ban9975/Thesis/README.md

# Hand Gesture Recognition Wristband Based on Resistance Sensing
## Abstract
Hand gesture recognition is a popular research topic, especially in the field of Human-Computer Interaction (HCI). This study focuses on developing a wearable hand gesture recognition device for human-computer interaction, which can be used to give commands to smart assistants through gestures or be utilized as an input interface for VR/AR systems with entertainment purposes.  

We aim to achieve several characteristics: comfort while wearing, usability anytime and anywhere, privacy preservation, and low cost. However, existing projects do not fully meet our requirements. Technologies based on computer vision and wireless signal detection lack mobility, while current wearable gesture recognition wristbands are not wearable enough. The closest existing work to our requirements is a wristband based on capacitive sensing, capable of detecting changes in wrist contours to recognize gestures. Nonetheless, this work has a drawback as the wristband is made from rigid silicone, leading to discomfort during wear, and it has a complex structure, resulting in higher production costs.  
 
Therefore, this study aims to improve this wristband design by retaining the idea of wrist contour recognition but using different types of sensors for recognition. After trying various materials, we discovered a material called conductive rubber. Conductive rubber is soft, elastic, and comfortable to wear, making it seemingly suitable for HCI devices. However, few works have utilized this material due to the nonlinearity between resistance change and elongation proportion.  

In this study, we first conducted extensive measurements on conductive rubber cord to build a model for the resistance change of it. We found that resistance value exhibits significant changes when subjected to small extensions. Based on this discovery, we decided to use conductive rubber cord as a sensor on the wristband and employ a resistance sensing approach for gesture recognition. We then created the wristband using conductive rubber cords and denim fabric. By employing the previously developed resistance model and a calibration algorithm for the collected data, we fed the calibrated data into a Random Forest Classifier to recognize the gestures made by the user.
## Experiment Instruction
### Video Link
https://youtu.be/pAtT-bNWfoI
### System Overview   
#### Hardware Setup
We used Arduino Uno to collect signals from conductive rubber cords. The analog signals would be converted to digital signals by ADC module ADS1015 first, and then transferred to PC via bluetooth module HC-05.  
system_s
#### Bluetooth Connection  
* Bluetooth program cou be found in **4 Program/BT_pyServer/**.  
* Find out which COM port does your PC use to connect to the bluetooth module.  
  Find the COM port (Windows) by selecting **Start > Settings > Devices > Bluetooth & other devices** and then **More Bluetooth options > COM ports**. Our bluetooth module is called `BioLabG2` here.  
  btCOM
* Change the COM port in **4 Program/BT_pyServer/interface.py**, line 10, 11.
  ```python
  while(not self.ser.do_connect("<YOUR_COM_PORT>")):
    self.ser.do_connect("<YOUR_COM_PORT>")
  ```
### Stretch-Resistance model of Materials
#### Collecting Data
We saved the measured data in **3 Data/materials/**. While running, this program printed the resistance values on console. We then copied these values into excel files manually.  
* Connect the testing sample between A0 on ADC and ground.  
  circuit_sample
* Upload **4 Program/BT_Arduino/BT_resistance/BT_resistance.ino** to Arduino board.
* On PC, run the measuring program. This program measures one value at a time.  
  ```bash
  > cd "4 Program/BT_pyServer/"
  > python BTRes_print.py
  ```
* In each run, this program asks how many iterations you'd like to test. The default value is 1 iteration.  
* Enter `e` to close the program.  
#### Fit the Surface for **calibration with length**
* Open **4 Program/plot/draw3D.m**.
* Specify the file containing measurement data in line 13.
  ```Matlab
  resT = readtable("<PATH_TO_FILE>", opts, "UseExcel", false);
  ```
* After running the code, the parameters of fit surface are shown on the console. These values are used in `calibration with length` in the training phase.
 * Key the values into **4 Program/rf/importDataRaw.py**, line 6\~14 and 29\~37. The values here are generated from `fitType="poly23"`.
   ```python
   p00 = -0.619036213083872
   p10 = -0.030800170966657
   p01 = 1.688322998396718
   p20 = -0.000611641511412
   p11 = 0.057794560352152
   p02 = -1.531793071531490
   p21 = 0.000488277935669
   p12 = -0.025444713548645
   p03 = 0.462421072634841
   ```
### Resistance Values of Gestures
#### Gestures Set
gestures  
#### Collecting Data
We saved the measured data in **3 Data/wristbands/**. While running, this program saved the measured values to the specified file automatically.
* Upload **4 Program/BT_Arduino/BT_resistance/BT_4resistance.ino** to Arduino board.
* Specify which file you want to write in `fileName` in **4 Program/BT_pyServer/BTRes_saveRaw.py**, line 10. Note that this file should be an existing file.  
* On PC, run the measuring program. This program measures four values at a time.  
  ```bash
  > cd "4 Program/BT_pyServer/"
  > python BTRes_saveRaw.py
  ```
  This program will ask you which measuring mode do you want to use once you run it. There are two modes: `calibration` and `random`.
 *  Measure in `calibration` mode.  
    We use `stretch` gesture as the calibration gesture. In calibrication mode, this program asks you to perform `stretch` several times. In our experiment, we collect 15 measurements for calibration data.  
 *  Measure in `random` mode.  
    In random mode, this program asks you to perform each gesture respectively. In our experiment, we collect 105 measurements for training dataset and 35 measurements for testing dataset.  
 * Enter `e` to close the program.
### Recognizing Gestures Using Random Forest
```bash
> cd "4 Program/rf/"
> python rfRaw.py
```
This program will ask you to choose the calibration mode and the version of the wristband. And then, you can decide whether to save the calibrated data. The calibrated data is saved in **5 Result/wristband/calibrated/** if you choose to save it. The `calibration with length` mode takes more time than other calibration modes.  

After finish the prediction, this program will show the training/validation/testing accuracy, respectively, on the console, and then generate the confusion matrices for validation and testing results. The confusion matrices are saved in **5 Result/wristband/conMat/**.
### RandomizedSearchCV
This program was designed to find the optimal hyperparameter set.  
You can specified the range of each parameter you want to test in **4 Program/rf/rf_randomizeCVRaw.py**, line 17\~23. The parameters are: `n_estimators`,  `max_features`, `max_depth`, `min_samples_split`, `min_samples_leaf`, and `bootstrap`.
```bash
> cd "4 Program/rf/"
> python rf_randomizeCVRaw.py
```
After randomly try on the parameter set for `n_iter` rounds, this program shows the set with highest accuracy on the console.
### Generating the Plots
#### plot_material.py
This program generates plot for single length. I draws each set of measurement as a line and computes the standard deviation and average of these values. You need to type file name and sheet name as command line arguments.
```bash
> cd "4 Program/plot/
> python plot_material.py <FILE_NAME> <SHEET_NAME>
```
There are some inputs needed:  
`_length`: a float, 
`_start`: an int, specify the starting row of the data.  
`_end`: an int, specify the ending row of the data.  
`_reps`: an int, specify how many repetitions in each set.
`_sets`: an int, specifies how many sets of values do we measure.  
`plotName`: a string. The plot will be saved as **5 Result/rubberCord/\<PLOTNAME\>.png**  

In the previous experiments (**otherMaterials.xlsx**), we took 5 samples (_reps = 5) at a time and repeated it for 3 sets (_sets = 3). After moving on to measure the resistance values of conductive rubber cords, we changed the experiment setup and took only 1 samples at a time and repeated it for 10 sets.

Following are sample input and the resulted plots:  
  
8cm
8cm_SD  
This program can generate plots using `stretch`, `reps', and 'angle' as x-axis. There are some lines need to be commented/uncommented. Please find details in the code.

#### plot_all.py
This program generates "Overall" plots. It takes average of different values measured from the same length and stretch. You need to type file name and sheet name as command line arguments.
```bash
> cd "4 Program/plot/
> python plot_all.py <FILE_NAME> <SHEET_NAME>
```
There are some inputs needed:  
`_start`: a list of ints, specify the starting row of each line.  
`_end`: a list of ints, specify the ending row of each line.  
`_sets`: an int, specifies how many measurements for each (length, stretch) pair. This also means how many columns of data do we have. 
`_lines`: an int, specifies how many lines will be drawn on the plot.  
`plotName`: a string. The plot will be saved as **5 Result/rubberCord/\<PLOTNAME\>.png**  

Following are sample input and the resulted plot:  
  
newCord_20_all  
This program can generate plots using `stretch`, `length + stretch', and 'angle' as x-axis. There are some lines need to be commented/uncommented. Please find details in the code.
#### plot_wristband.py
This program generates a scatter plot with different gestures for each sensor. The plots will be saved in **5 Result/wristband/calibrated/plot/**.  
```bash
> cd "4 Program/plot/
> python plot_wristband.py
```
Following are sample input and the resulted plot:  
  
v4_gesture_0
v4_gesture_1  
v4_gesture_2
v4_gesture_3
