ban9975/Thesis/1 Presntation/20230612 oral defense.pdf

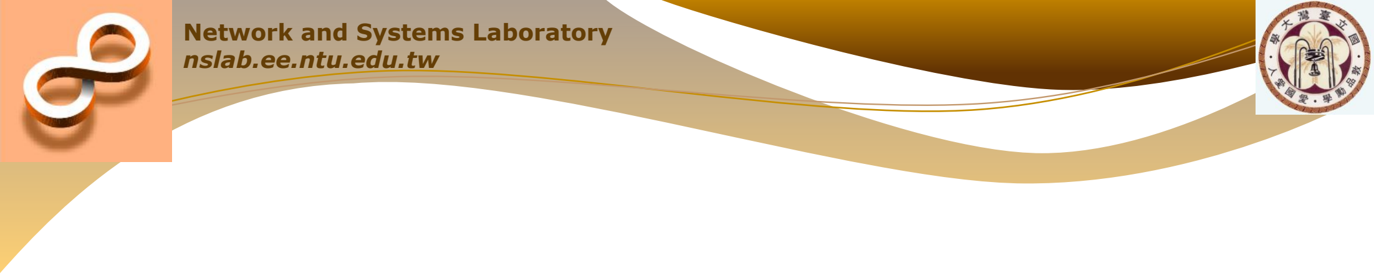
[picture p75: figure]
Network and Systems Laboratory nslab.ee.ntu.edu.tw

## Hand Gesture Recognition Wristband Based on Resistance Sensing

R10921072 Pei-Shin Hwang 黃珮欣 Network and Systems Laboratory Graduate Institute of Electrical Engineering National Taiwan University
June 12th, 2023
Copyright © 2008 | 1

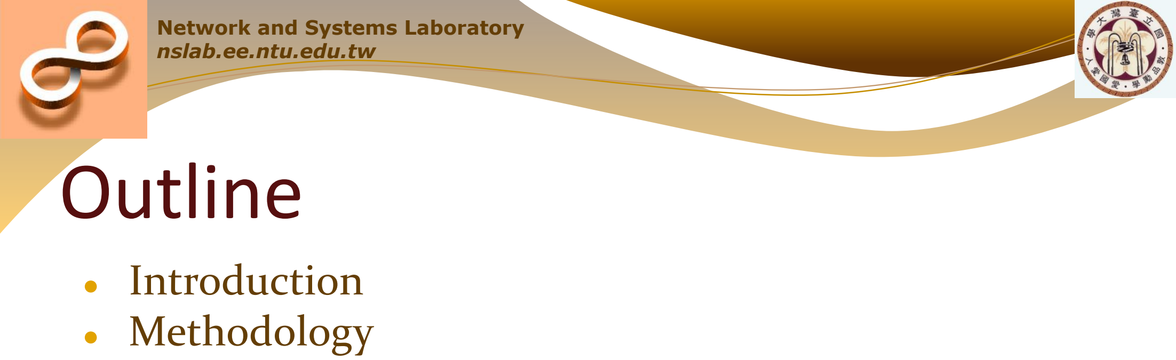
[picture p76: figure]
Outline; ● Introduction ● Methodology

- Exploration of Materials
- Experiments
- Results
- Conclusion
- Q&A

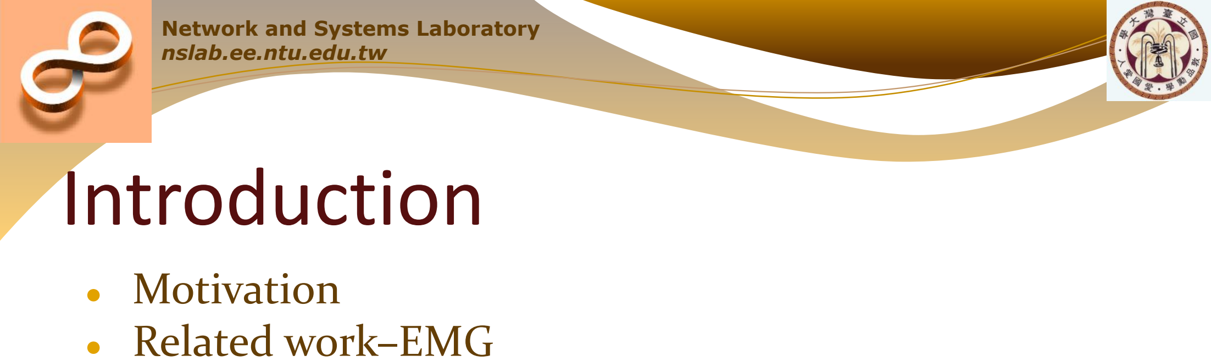
[picture p77: figure]
Introduction; ● Motivation ● Related work–EMG

- Related work–flex sensor
- Related work–CapBand
- Thesis statement
- Contributions

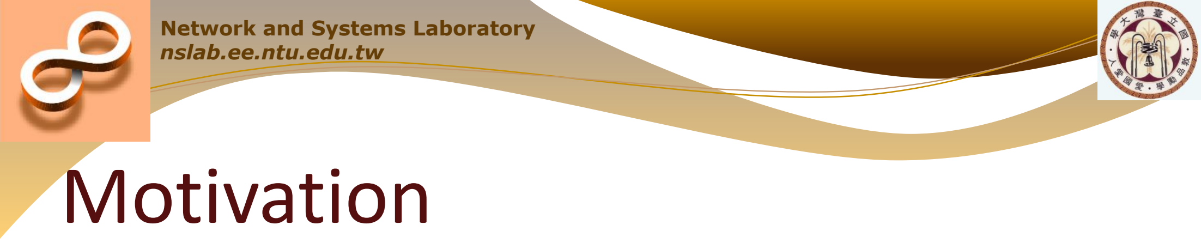
[picture p78: figure]
Motivation

Why are current hand gesture recognition systems not suitable for everyday use:
- Vision based:
- Privacy
- High compute capacity needed
- Wireless signal based:
- Low gesture resolution
- Room-scale recognition
- Wearable devices:
- Not wearable enough

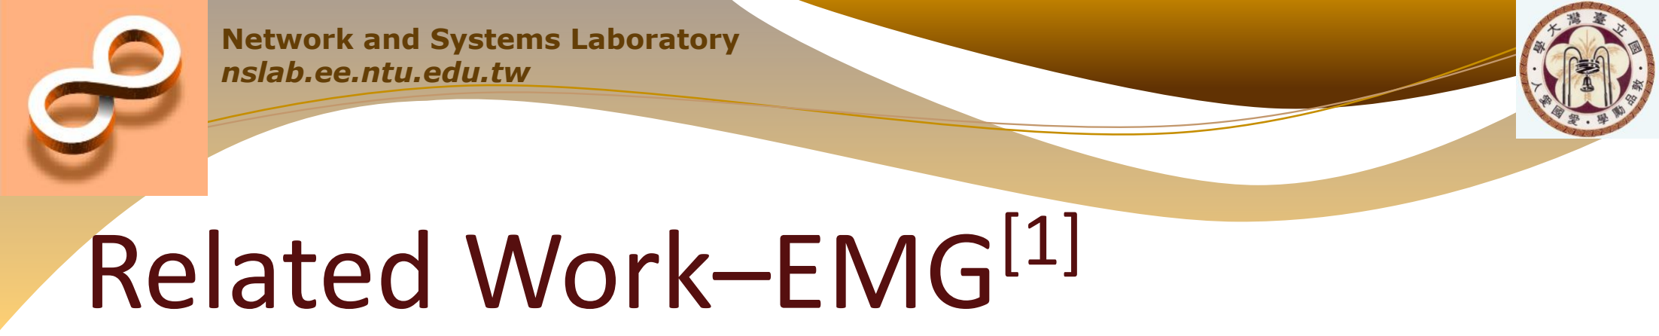
[picture p79: figure]
Related Work–EMG[1]

- Sense the neural signal produced by our brain
- Need to attach electrodes on users’ skin surface

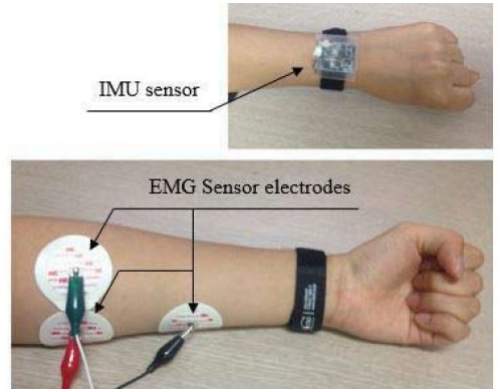
[picture p80: figure]

# Related Work–Flex Sensor[2]

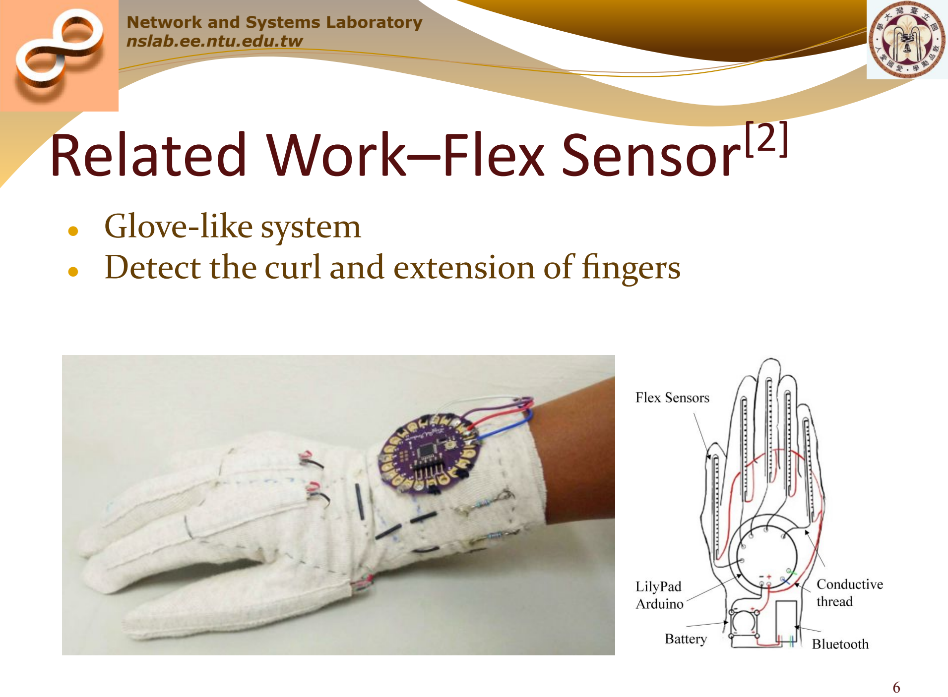
[picture p81: page 6]

- Glove-like system
- Detect the curl and extension of fingers

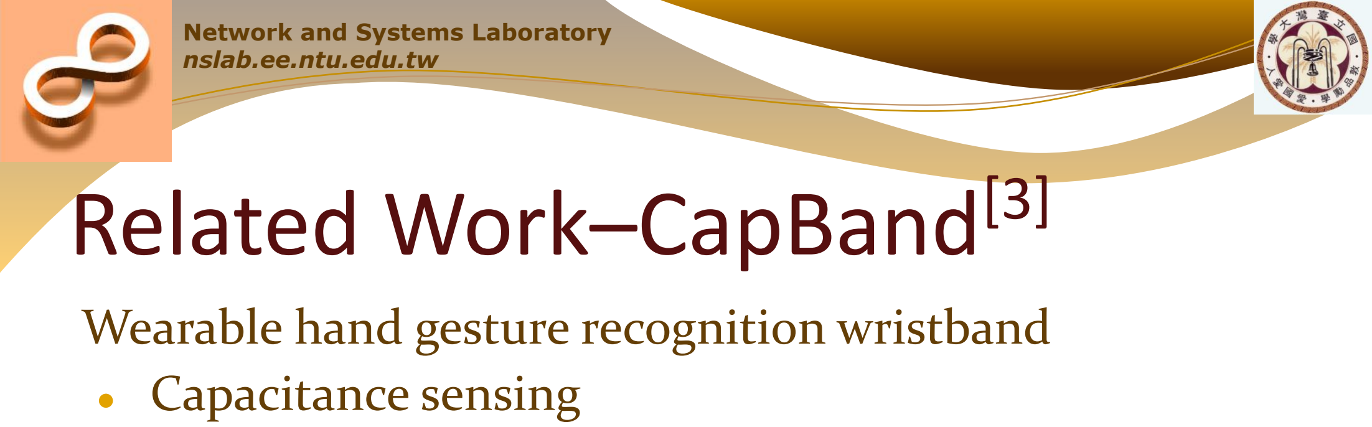
[picture p82: figure]
Related Work–CapBand[3]; Wearable hand gesture recognition wristband ● Capacitance sensing

- Recognize gestures by wrist contour
- Down side:
- Costly
- Tight
- Hard

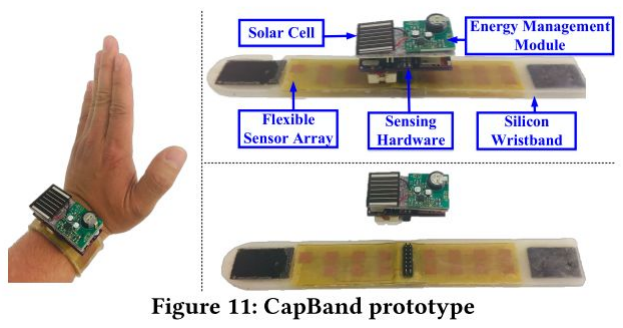
[picture p83: figure]

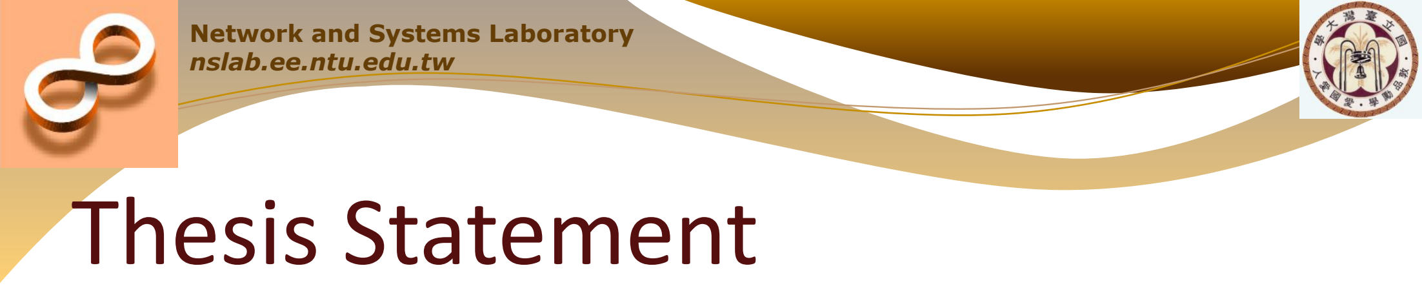
[picture p84: figure]
Thesis Statement

Goal: a CapBand-like wristband but with lower cost and more comfortable
How:
- Recognize gestures by wrist contour
- Use soft material to make the wristband
- Make wristband with cheaper and simpler structure
- Denim fabric
- Conductive rubber cord

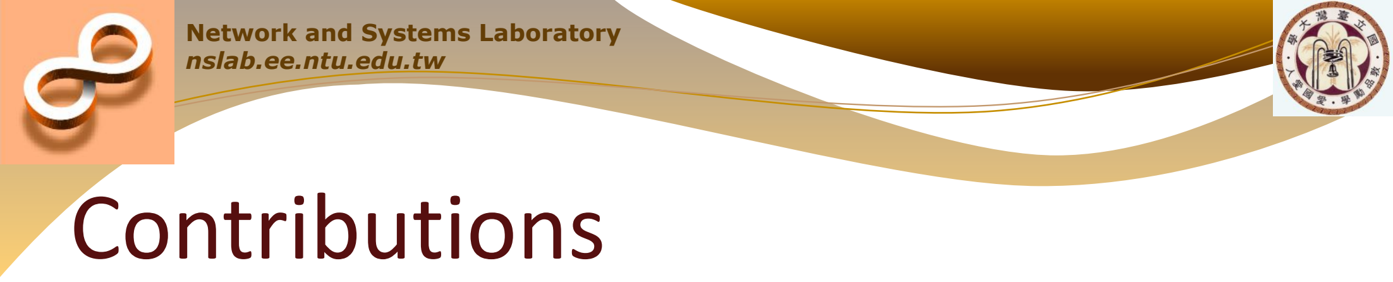
[picture p85: figure]
Contributions

- Find a material suitable for sense the length change
- Build a model between the resistance value and length of conductive rubber cord
- Make a wristband using conductive rubber cord

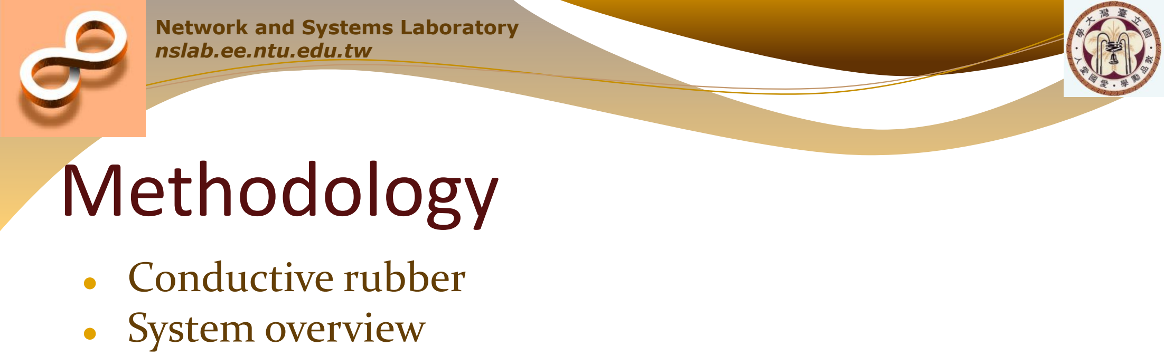
[picture p86: figure]
Methodology; ● Conductive rubber ● System overview

- Measurement of conductive rubber cord
- Wristband design
- Recognition flow

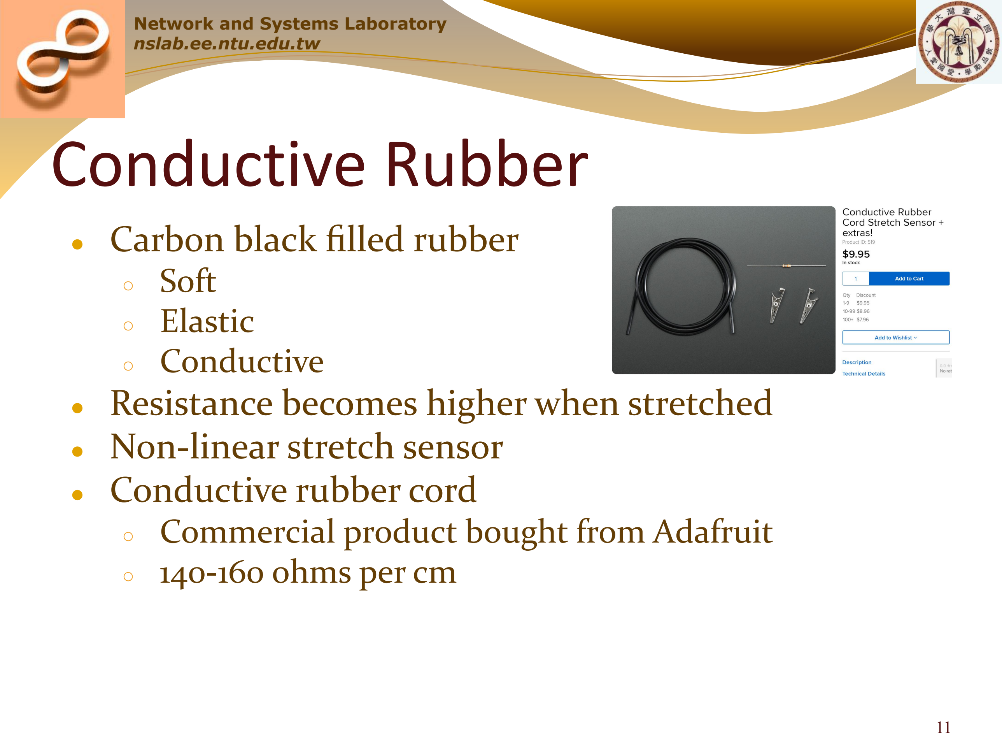
[picture p87: figure]
Conductive Rubber; ● Carbon black filled rubber ○ Soft ○ Elastic ○ Conductive; ● Non-linear stretch sensor ● Conductive rubber cord; ○ 140-160 ohms per cm

- Resistance becomes higher when stretched
- Commercial product bought from Adafruit

# System Overview–Hardware

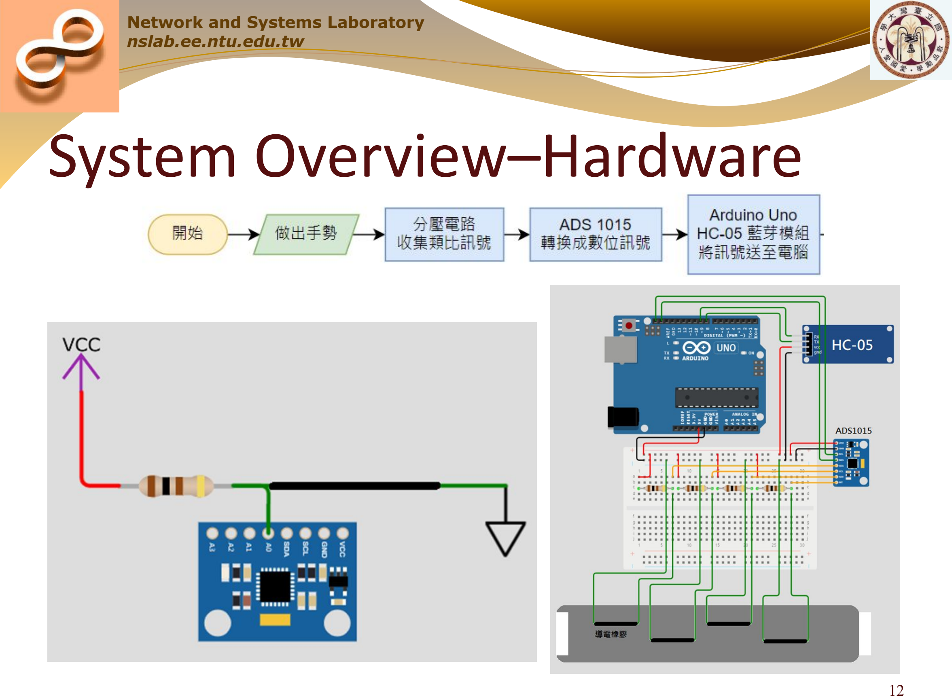
[picture p88: page 12]

## Measurement of Conductive Rubber Cord

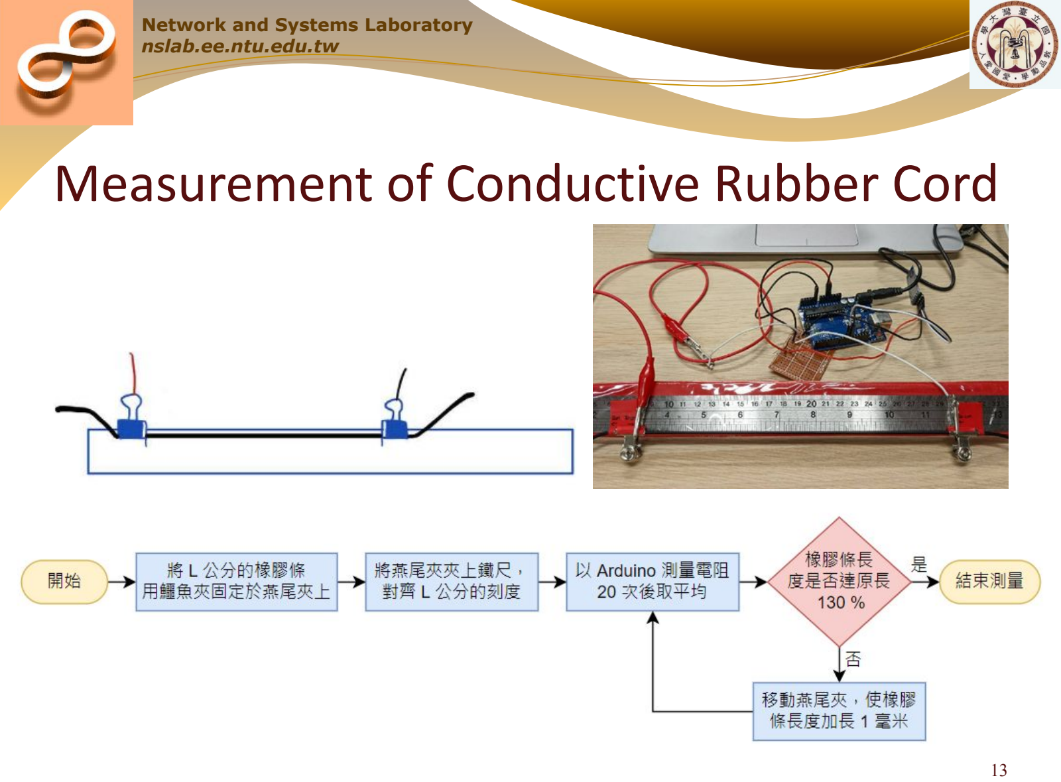
[picture p89: page 13]

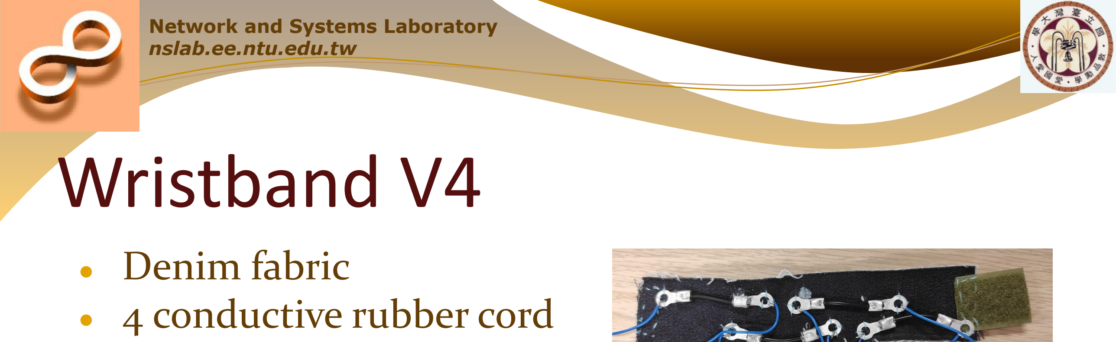
[picture p90: figure]
Wristband V4; ● Denim fabric ● 4 conductive rubber cord

- 2 cm each

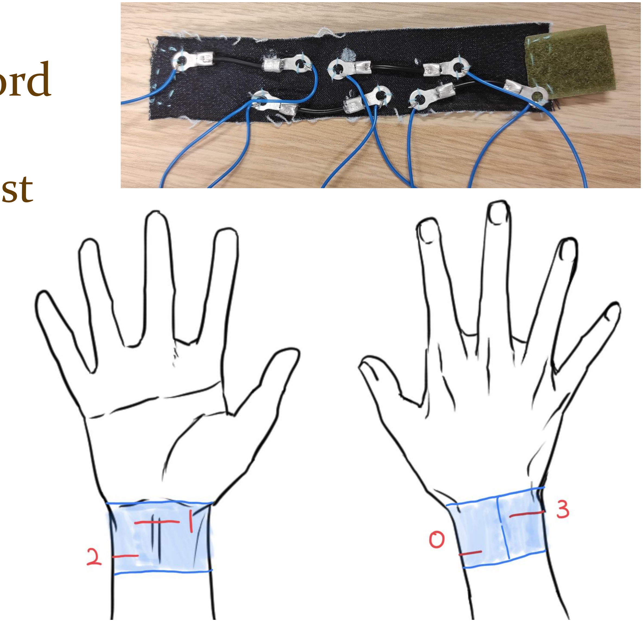
[picture p91: figure]

- Wrap around the wrist

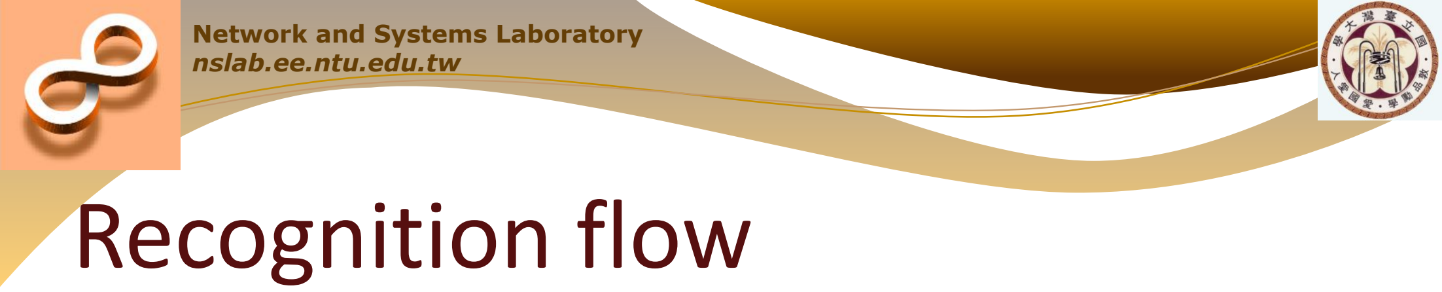
[picture p92: figure]
Recognition flow
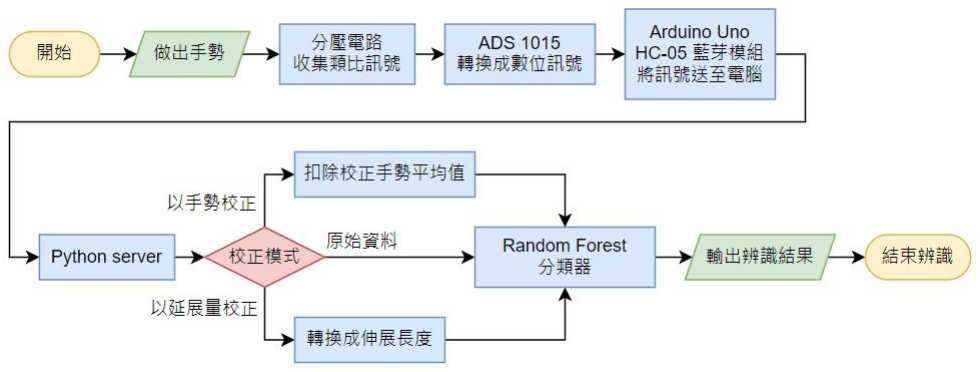
[picture p93: figure]

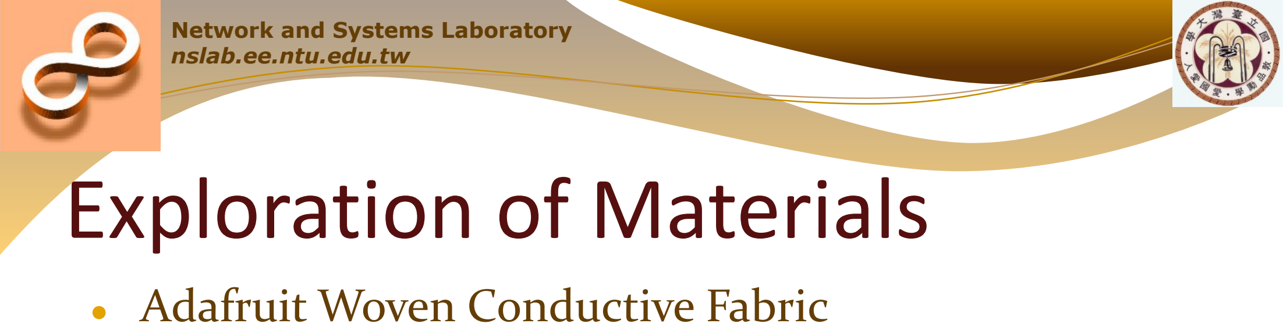
[picture p94: figure]
Exploration of Materials; ● Adafruit Woven Conductive Fabric

- Adafruit Knit Jersey Conductive Fabric
- Adafruit Conductive Rubber Sheet
- Adafruit Conductive Rubber Cord
- Length-Resistance Model of Rubber Cord

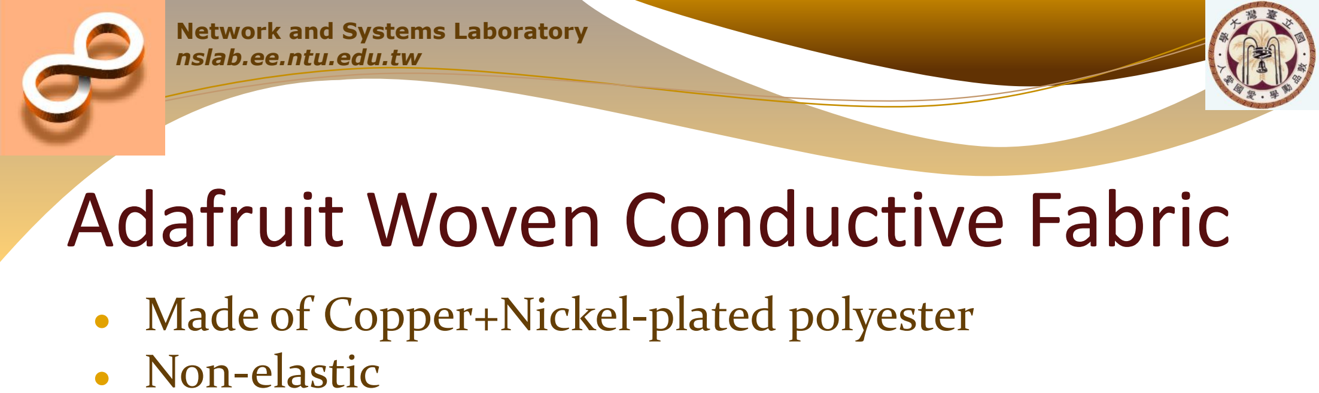
[picture p95: figure]
Adafruit Woven Conductive Fabric; ● Made of Copper+Nickel-plated polyester ● Non-elastic
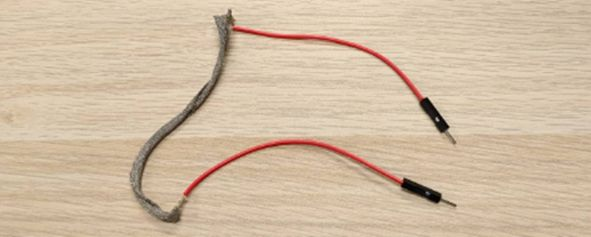
[picture p96: figure]

## Adafruit Knit Jersey Conductive Fabric

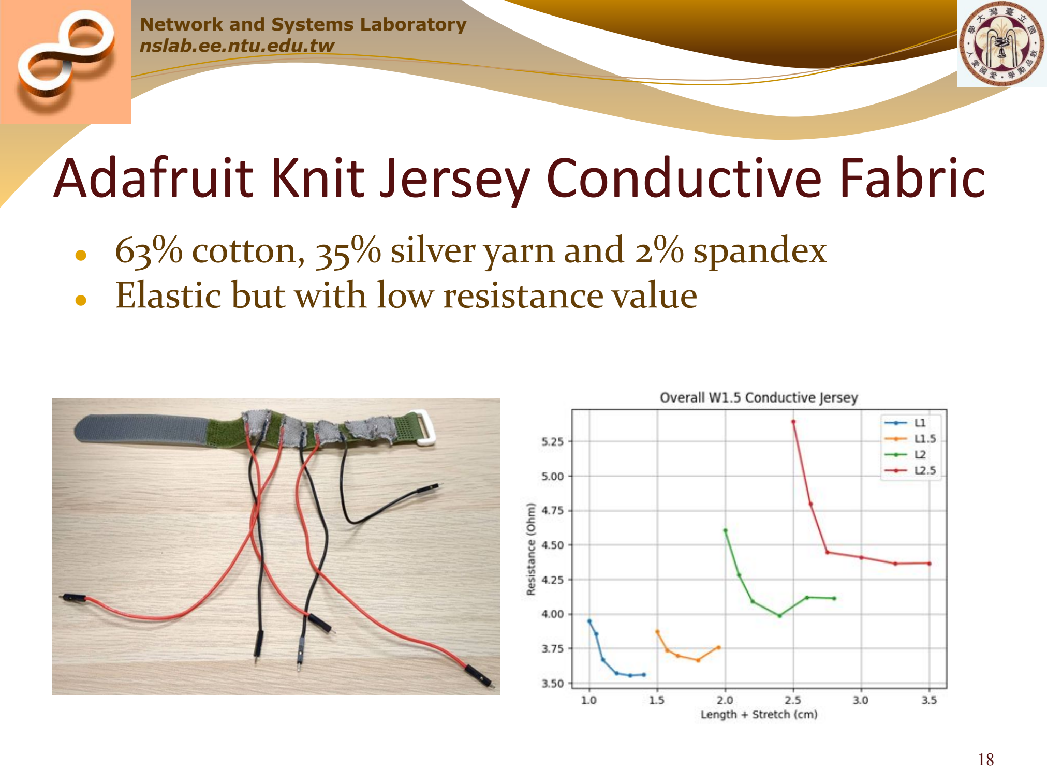
[picture p97: page 18]

- 63% cotton, 35% silver yarn and 2% spandex
- Elastic but with low resistance value

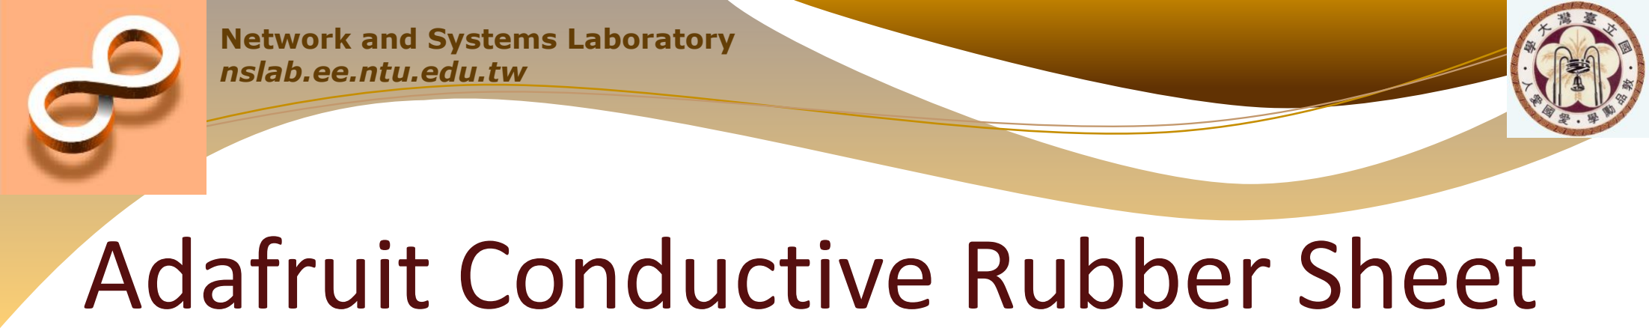
[picture p98: figure]
Adafruit Conductive Rubber Sheet
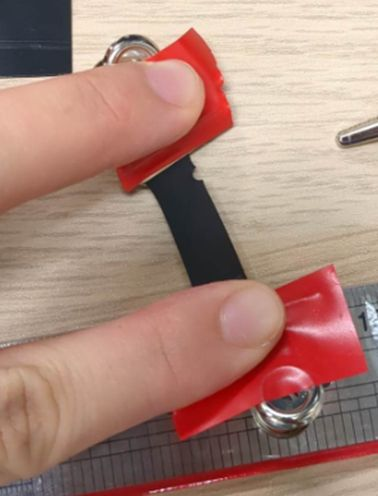
[picture p99: figure]
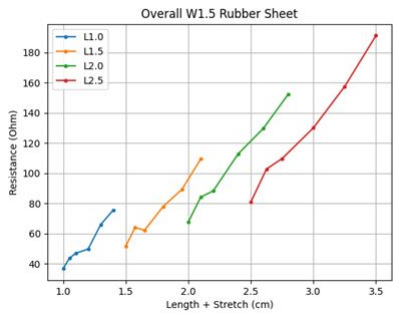
[picture p100: figure]

- Made of carbon-black impregnated rubber material
- Take long time to recover after stretched
- Not durable enough

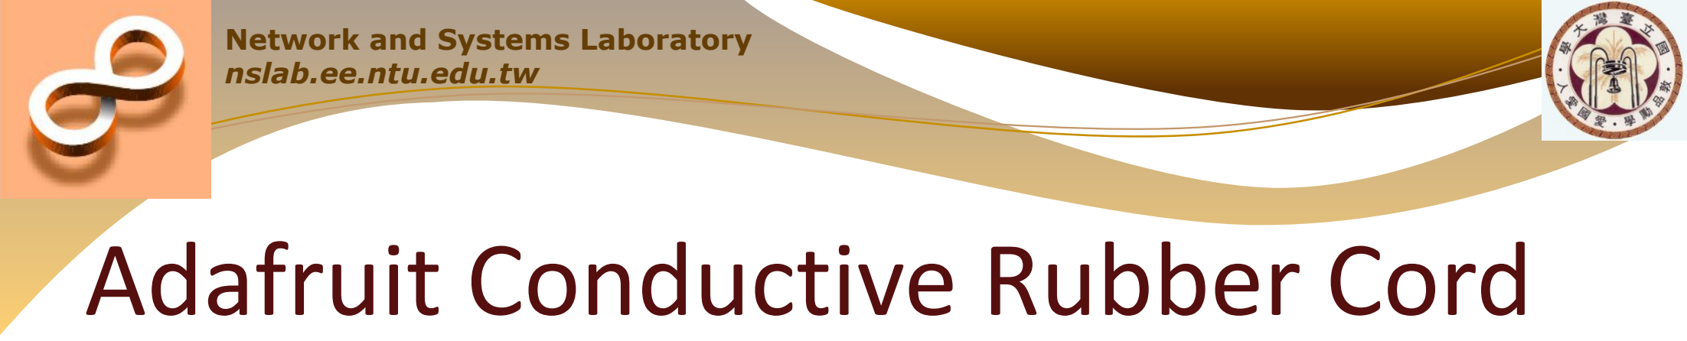
[picture p101: figure]
Adafruit Conductive Rubber Cord

- Made of carbon-black impregnated rubber material
- Resistances rise fast when slightly stretched

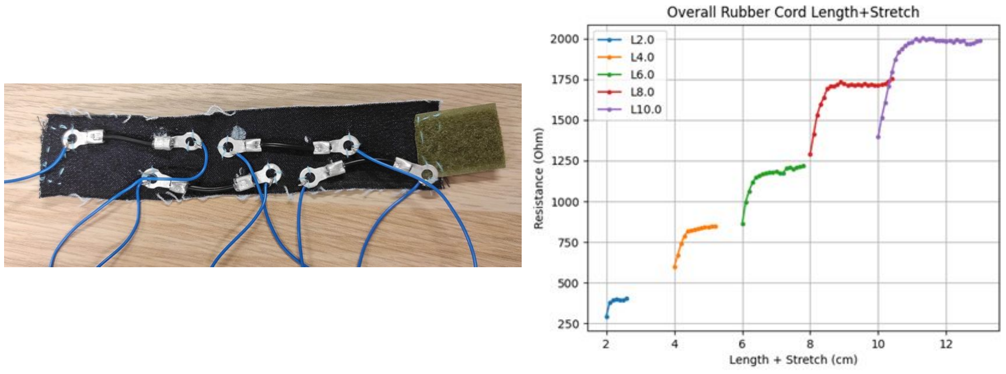
[picture p102: figure]

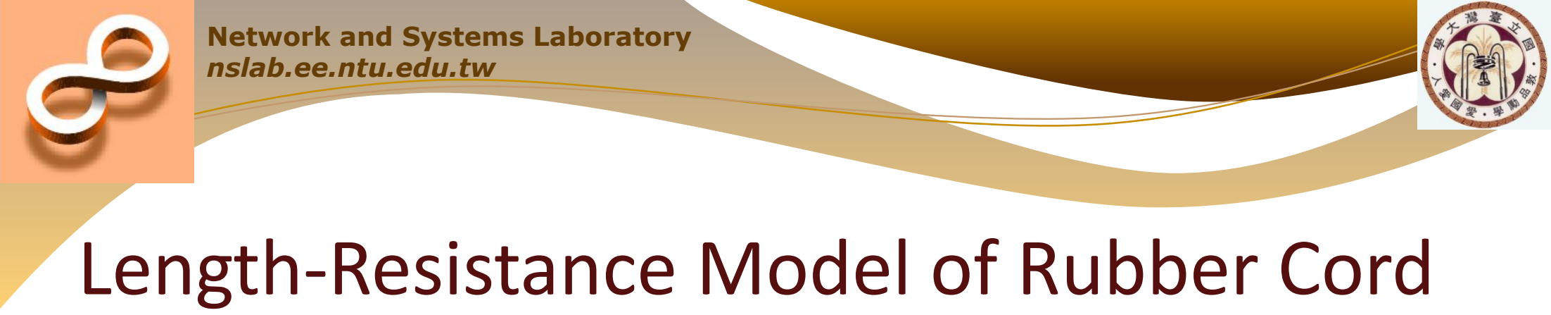
[picture p103: figure]
Length-Resistance Model of Rubber Cord

- Matlab fit with fit type poly23
- Data size: (5 + (2 + 4 + 6 + 8 + 10) * 2) * 10 = 650

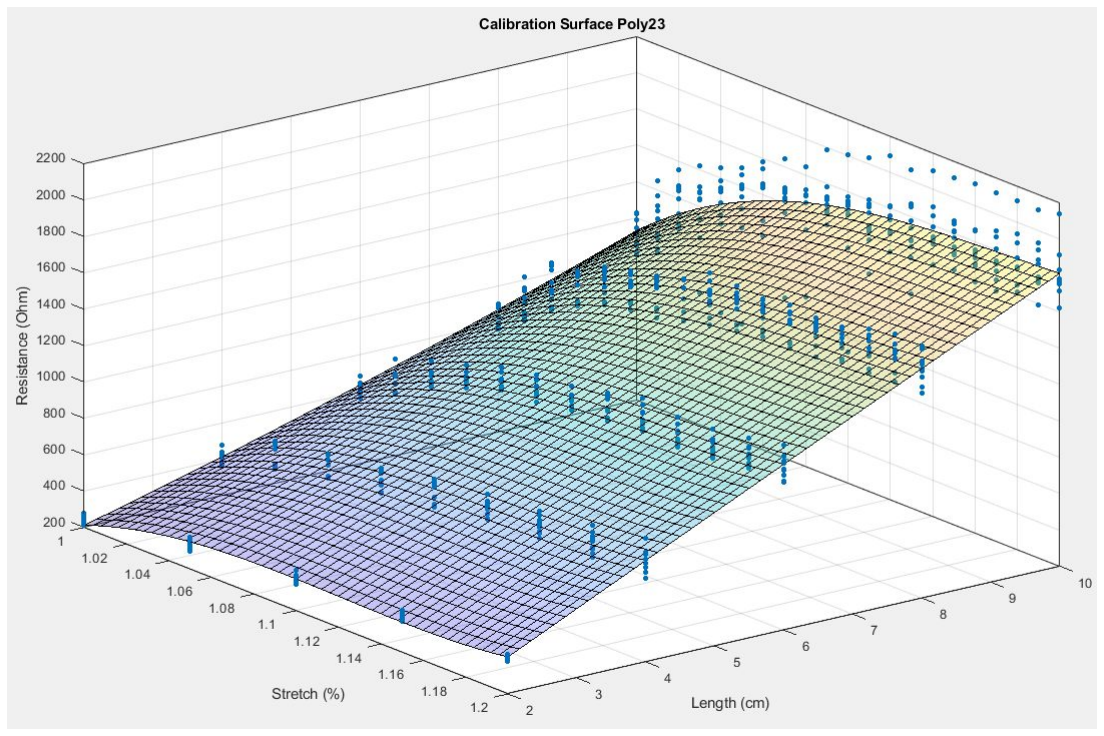
[picture p104: figure]

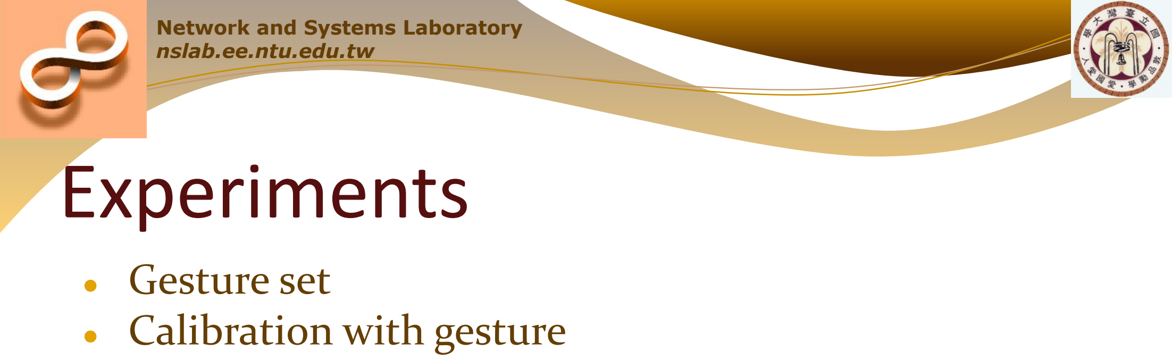
[picture p105: figure]
Experiments; ● Gesture set ● Calibration with gesture

- Calibration with length
- Length-Resistance Model for Calibration
- Random forest classification

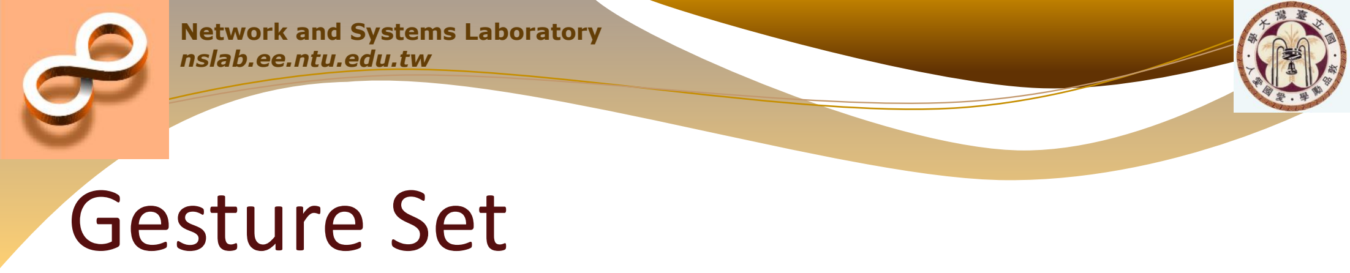
[picture p106: figure]
Gesture Set

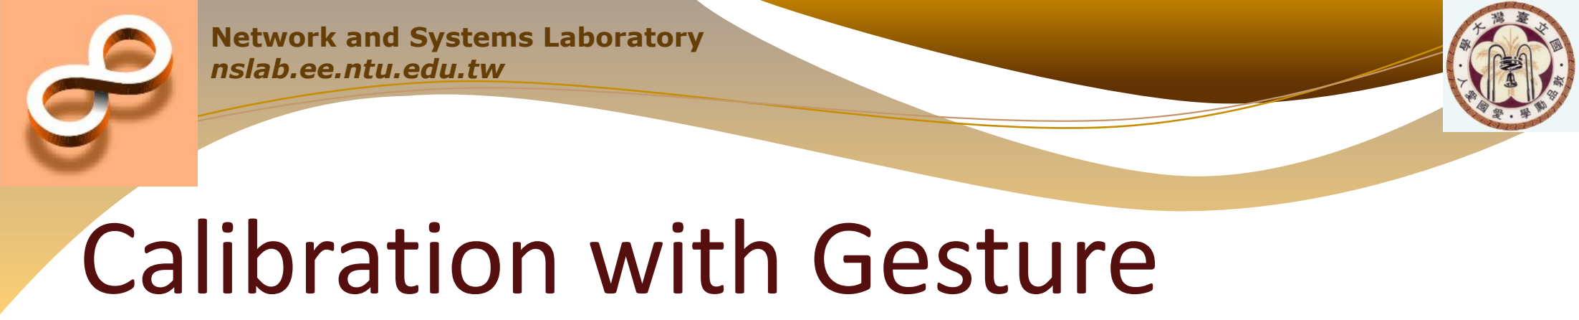
[picture p107: figure]
Calibration with Gesture
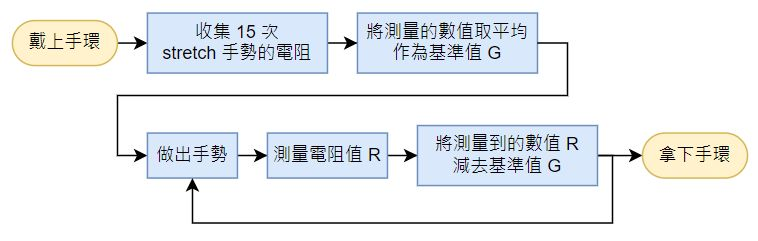
[picture p108: figure]

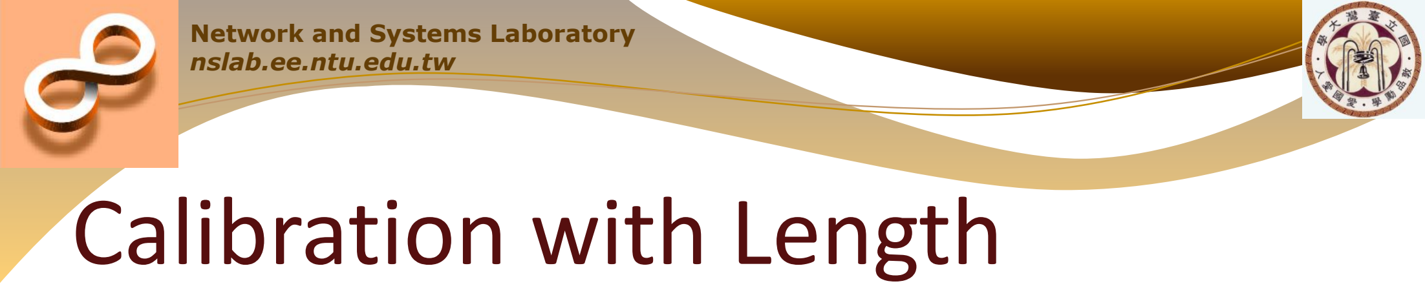
[picture p109: figure]
Calibration with Length
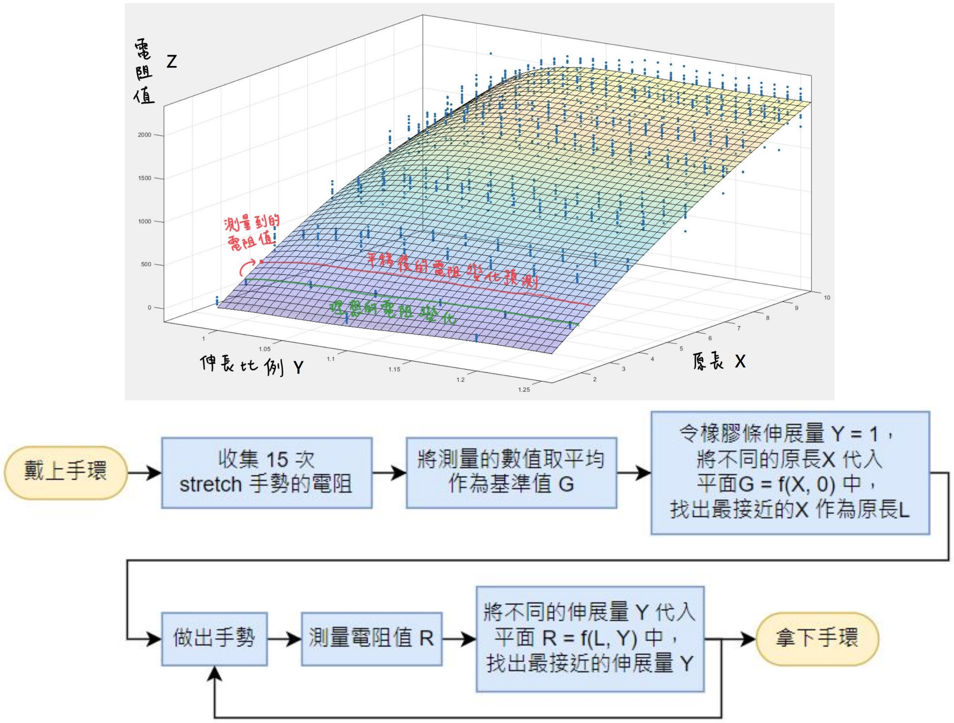
[picture p110: figure]

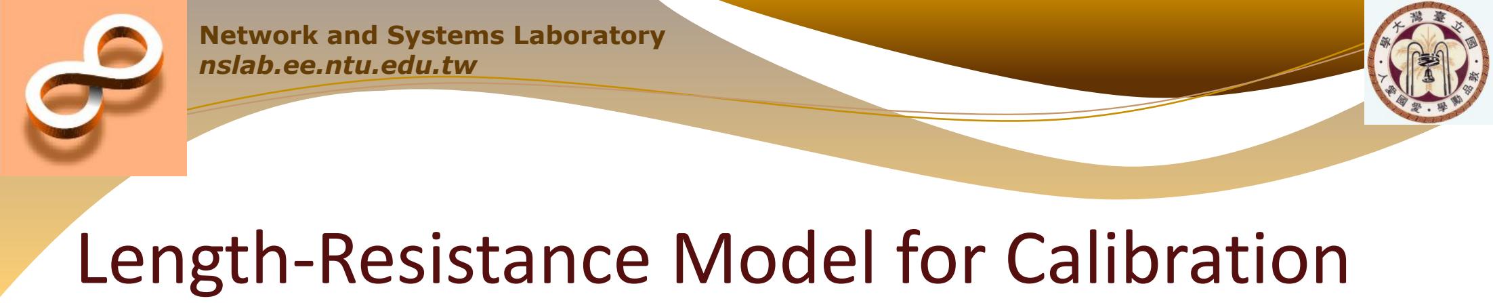
[picture p111: figure]
Length-Resistance Model for Calibration

- Matlab fit with fit type poly23
- Data size: (4 + (1 + 2 + 3 + 4) * 2) * 10 = 240

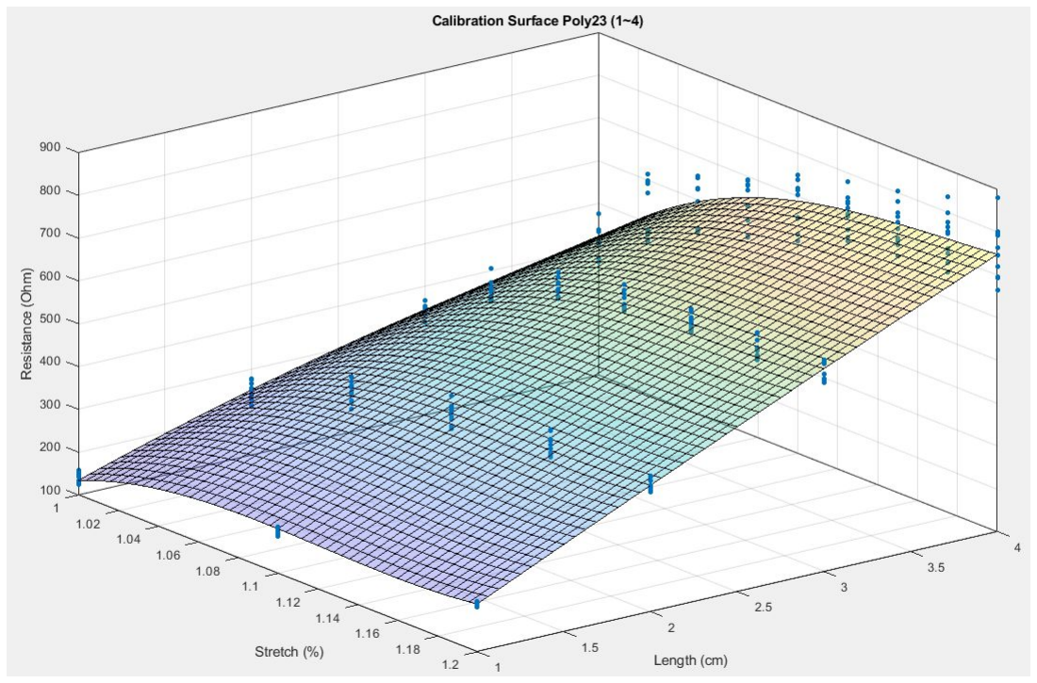
[picture p112: figure]

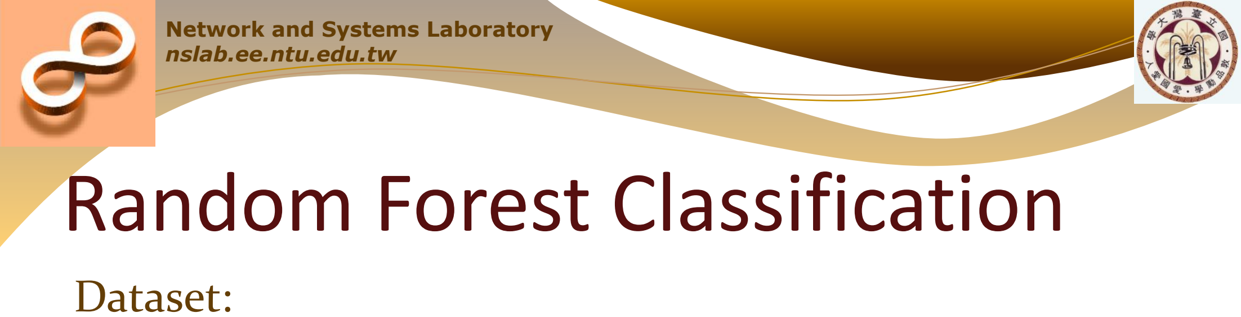
[picture p113: figure]
Random Forest Classification; Dataset:

- Training: (15 + 105) * 2
- Testing: (15 + 35) * 1
sklearn.RandomForestClassifier

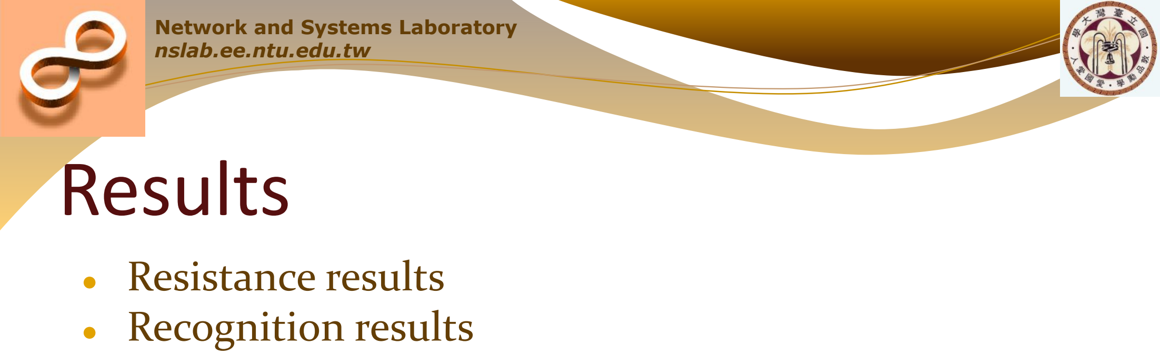
[picture p114: figure]
Results; ● Resistance results ● Recognition results

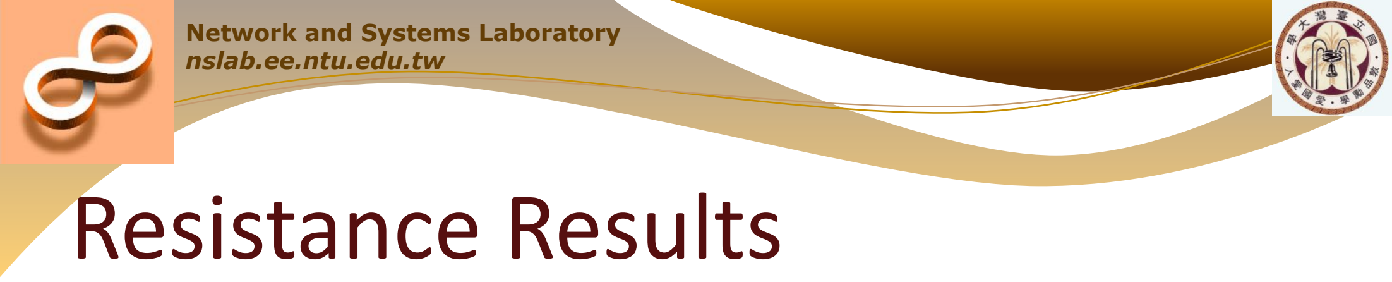
[picture p115: figure]
Resistance Results
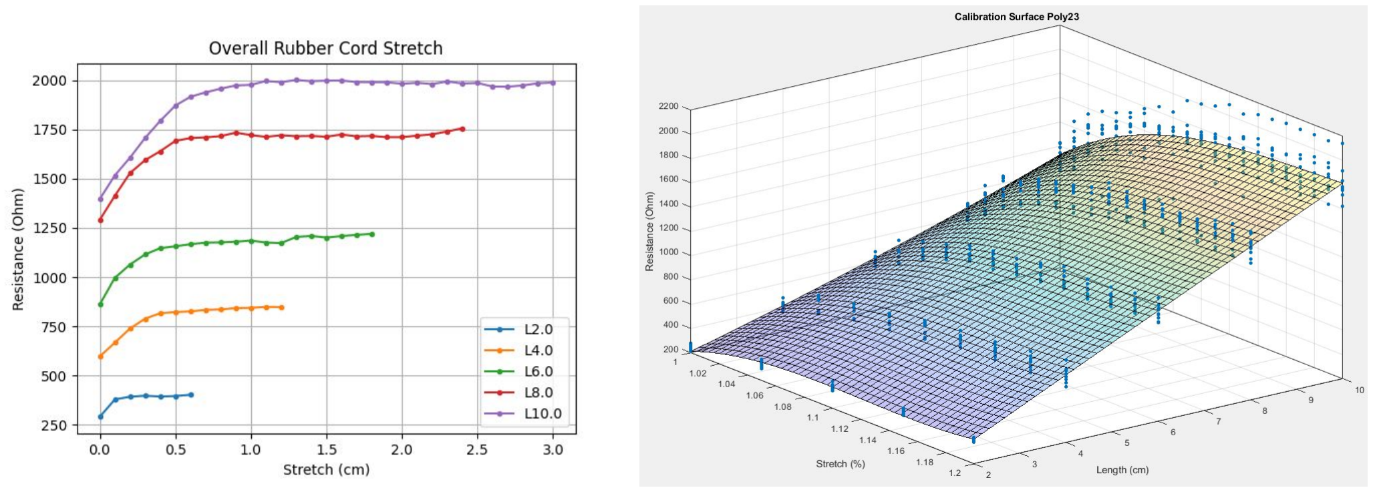
[picture p116: figure]

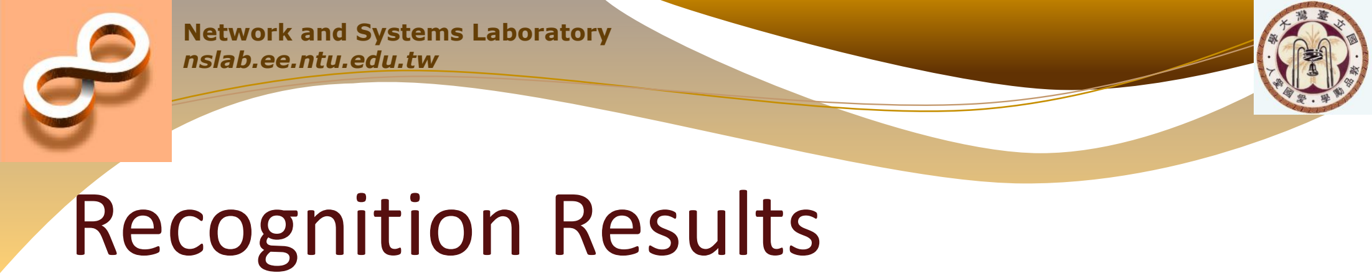
[picture p117: figure]
Recognition Results
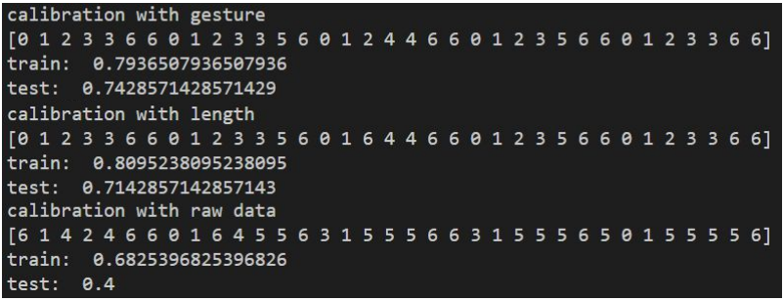
[picture p118: figure]

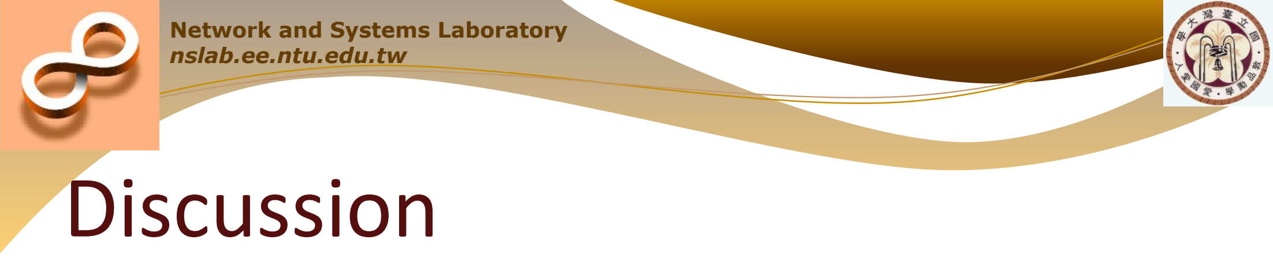
[picture p119: figure]
Discussion

- Certain gestures are hard to recognize
- Decreasing resistance value
- Unstable calibration values between rounds

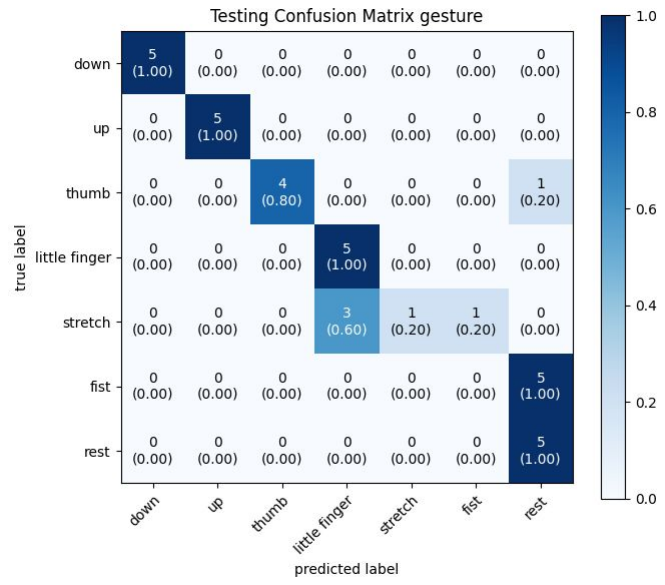
[picture p120: figure]

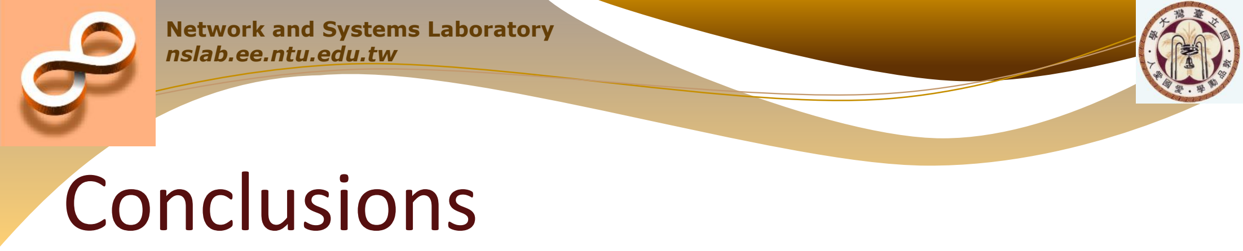
[picture p121: figure]
Conclusions

- Resistance Sensing gesture recognition wristband
- Using conductive rubber cord to build the wristband
- Dealing with non-linearity of conductive rubber cord
- Hand gesture recognition wristband
- Privacy
- For everyday use
- Cheap

Q&A

Copyright © 2008 | 34

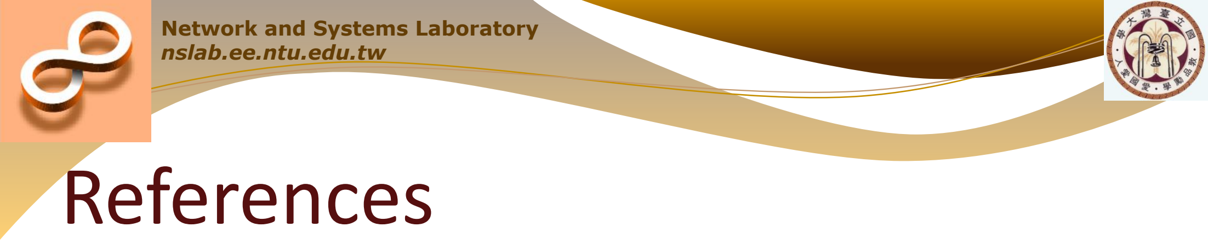
[picture p122: figure]
References

[1] Seong-Og Shin, Donghan Kim, and Yong-Ho Seo “Controlling Mobile Robot Using IMU and EMG Sensor-based Gesture Recognition”
[2] Wei-Chieh Chung, Wen-Jyi Hwang, Tsung-Ming Tai, De-Rong Huang, and Yun-Jie Jhang “Continuous Finger Gesture Recognition Based on Flex Sensors”
[3] Hoang Truong, Phuc Nguyen, Qin Lv, Shuo Zhang, Nam Bui, Kaushik Chowdhury, Tam Vu, Ufuk Muncuk, Anh Nguyen, Thang Dinh “CapBand: Battery-free Successive Capacitance Sensing Wristband for Hand Gesture Recognition”
