ban9975/Thesis/5 Result/otherMaterials/Conductive Jersey W1.5 L2.5_SD.png

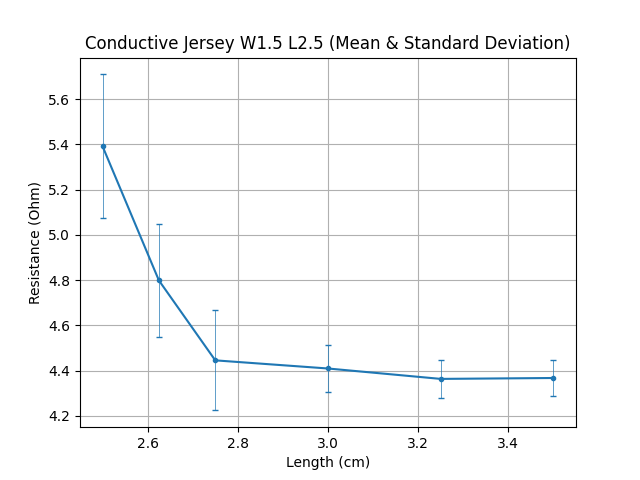
5 Result/otherMaterials/Conductive Jersey W1.5 L2.5_SD.png
