ban9975/Thesis/5 Result/otherMaterials/Overall L2 Rubber Sheet.png

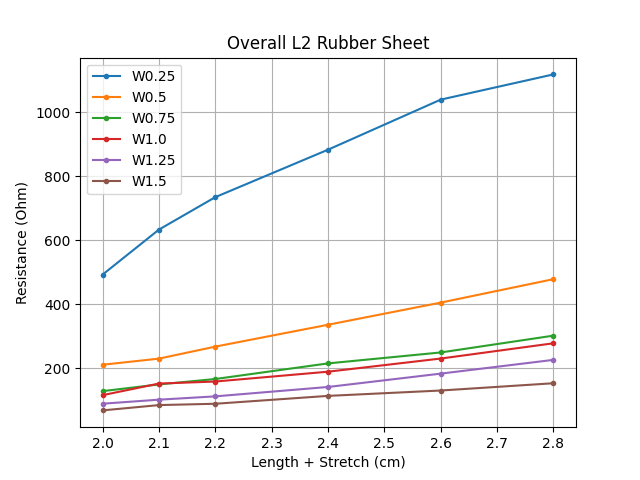
5 Result/otherMaterials/Overall L2 Rubber Sheet.png
