ban9975/Thesis/5 Result/otherMaterials/Overall W1.5 Rubber Sheet.png

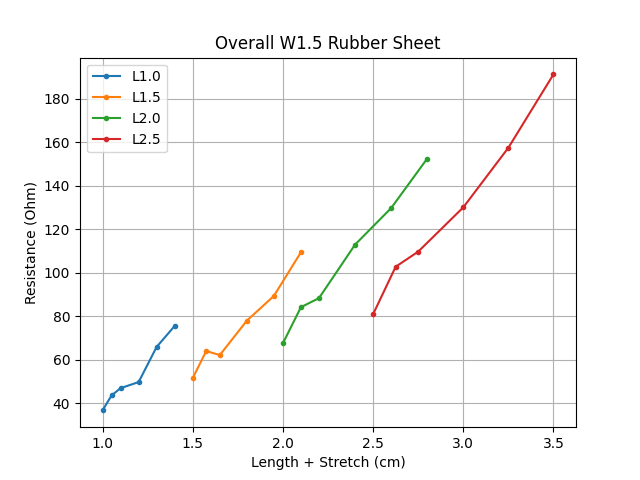
5 Result/otherMaterials/Overall W1.5 Rubber Sheet.png
