ban9975/Thesis/3 Data/wristbands/v4_test.xlsx

Sheet: calibration
gesture | start | end | 0 | 1 | 2 | 3
4 | 0:00:02.354047 | 0:00:03.582847 | 269 | 330.64 | 318.48 | 400.4
4 | 0:00:08.907947 | 0:00:10.081810 | 266.37 | 329.31 | 318.32 | 389.09
4 | 0:00:11.290134 | 0:00:12.508893 | 331.48 | 326.29 | 319.06 | 383.7
4 | 0:00:29.775842 | 0:00:31.119459 | 261.36 | 318.53 | 310.69 | 366.37
4 | 0:00:32.894940 | 0:00:34.126093 | 260.58 | 315.45 | 309.68 | 365.33
4 | 0:00:35.325255 | 0:00:36.536820 | 260.97 | 316.39 | 310.09 | 364.04
4 | 0:00:37.587000 | 0:00:38.780711 | 261.76 | 318.8 | 311.35 | 364.75
4 | 0:00:39.716071 | 0:00:40.885135 | 262.23 | 317.43 | 310.64 | 363.39
4 | 0:00:41.866870 | 0:00:43.273785 | 261.01 | 315.82 | 310.34 | 362.94
4 | 0:00:44.119026 | 0:00:45.300993 | 260.54 | 317.54 | 309.68 | 363.46
4 | 0:00:45.967830 | 0:00:47.142439 | 260.62 | 314.99 | 309.43 | 362.36
4 | 0:00:47.920815 | 0:00:49.121952 | 260.11 | 312.07 | 307.83 | 359.5
4 | 0:00:49.801238 | 0:00:50.978632 | 259.57 | 311.05 | 306.04 | 356.54
4 | 0:00:51.772648 | 0:00:53.303961 | 258.45 | 313.39 | 308.18 | 359.43
4 | 0:00:53.790160 | 0:00:54.987699 | 258.87 | 311 | 306.24 | 357.41
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
