ban9975/Thesis/5 Result/wristband/calibrated/v4_test_gesture.xlsx

 | gesture | 0 | 1 | 2 | 3
0 | 0 | -6.19 | -13.35 | -3.29 | 21.69
1 | 1 | 87.3 | 40.39 | -4.83 | 27.65
2 | 2 | 19.78 | -8.88 | -14.69 | -2.9
3 | 3 | 8.45 | 21.77 | -7.49 | 2.15
4 | 4 | 5.86 | 0.05 | -7.54 | -4.39
5 | 5 | 7.74 | -10.98 | -4.04 | -21.64
6 | 6 | 5.24 | -14.18 | -7.14 | -26.43
7 | 0 | 2.49 | 16.89 | 24.41 | 33.24
8 | 1 | 61.47 | 22.58 | -0.98 | 9.76
9 | 2 | 15.01 | -11.87 | -9.38 | -6.44
10 | 3 | 4.7 | 13.29 | -5.42 | -5.03
11 | 4 | 2.69 | 1.52 | -1.18 | -7.08
12 | 5 | 3.76 | -8.07 | -4.88 | -25.55
13 | 6 | 0.9 | -15.54 | -10.25 | -34.8
14 | 0 | -1.55 | 5.68 | 11.76 | 20.47
15 | 1 | 115.76 | 22.75 | 0.03 | 5.89
16 | 2 | 6.61 | -18.68 | -15.3 | -16.32
17 | 3 | -8.51 | -2.82 | -12.12 | -12.31
18 | 4 | -4.2 | -3.69 | -8.17 | -16.63
19 | 5 | -0.02 | -15.06 | -6.01 | -32.65
20 | 6 | -2.7 | -20.3 | -11.84 | -40.3
21 | 0 | -5.37 | 10.14 | 14.46 | 22.98
22 | 1 | 41.54 | 8.49 | -8.61 | -4.32
23 | 2 | 7.57 | -17.67 | -14.26 | -12.81
24 | 3 | -3.77 | -1.21 | -8.51 | -12.18
25 | 4 | -2.86 | -8.43 | -12.65 | -20.8
26 | 5 | -0.26 | -16.75 | -9.87 | -32.26
27 | 6 | -5.69 | -22.75 | -17.35 | -40.91
28 | 0 | -2.34 | 15.31 | 27.62 | 39.96
29 | 1 | 63.84 | 26.28 | -2.94 | 15.93
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
