ban9975/Thesis/5 Result/wristband/calibrated/v4_test_length.xlsx

 | gesture | 0 | 1 | 2 | 3
0 | 0 | -0.0022 | -0.0039 | -0.001 | 0.0054
1 | 1 | 0.0398 | 0.0128 | -0.0014 | 0.007
2 | 2 | 0.007 | -0.0026 | -0.0043 | -0.0009
3 | 3 | 0.0028 | 0.0066 | -0.0022 | 0.0004
4 | 4 | 0.0019 | -0.0001 | -0.0022 | -0.0012
5 | 5 | 0.0026 | -0.0032 | -0.0012 | -0.0054
6 | 6 | 0.0017 | -0.0041 | -0.0021 | -0.0065
7 | 0 | 0.0007 | 0.005 | 0.0077 | 0.0085
8 | 1 | 0.0251 | 0.0068 | -0.0003 | 0.0023
9 | 2 | 0.0052 | -0.0035 | -0.0028 | -0.0017
10 | 3 | 0.0015 | 0.0039 | -0.0016 | -0.0014
11 | 4 | 0.0008 | 0.0004 | -0.0003 | -0.0019
12 | 5 | 0.0012 | -0.0024 | -0.0014 | -0.0063
13 | 6 | 0.0002 | -0.0045 | -0.003 | -0.0084
14 | 0 | -0.0007 | 0.0016 | 0.0036 | 0.0051
15 | 1 | 0.063 | 0.0069 | 0 | 0.0013
16 | 2 | 0.0022 | -0.0054 | -0.0045 | -0.0041
17 | 3 | -0.003 | -0.0009 | -0.0035 | -0.0032
18 | 4 | -0.0016 | -0.0012 | -0.0024 | -0.0042
19 | 5 | -0.0002 | -0.0044 | -0.0018 | -0.0079
20 | 6 | -0.0011 | -0.0058 | -0.0035 | -0.0097
21 | 0 | -0.002 | 0.003 | 0.0045 | 0.0058
22 | 1 | 0.0158 | 0.0025 | -0.0025 | -0.0012
23 | 2 | 0.0025 | -0.0051 | -0.0042 | -0.0033
24 | 3 | -0.0014 | -0.0004 | -0.0025 | -0.0031
25 | 4 | -0.0011 | -0.0025 | -0.0037 | -0.0052
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
