ban9975/Thesis/5 Result/wristband/calibrated/v4_test_raw.xlsx

 | gesture | 0 | 1 | 2 | 3
0 | 0 | 260 | 304.56 | 307.78 | 389.6
1 | 1 | 353.49 | 358.3 | 306.24 | 395.56
2 | 2 | 285.97 | 309.03 | 296.38 | 365.01
3 | 3 | 274.64 | 339.68 | 303.58 | 370.06
4 | 4 | 272.05 | 317.96 | 303.53 | 363.52
5 | 5 | 273.93 | 306.93 | 307.03 | 346.27
6 | 6 | 271.43 | 303.73 | 303.93 | 341.48
7 | 0 | 268.68 | 334.8 | 335.48 | 401.15
8 | 1 | 327.66 | 340.49 | 310.09 | 377.67
9 | 2 | 281.2 | 306.04 | 301.69 | 361.47
10 | 3 | 270.89 | 331.2 | 305.65 | 362.88
11 | 4 | 268.88 | 319.43 | 309.89 | 360.83
12 | 5 | 269.95 | 309.84 | 306.19 | 342.36
13 | 6 | 267.09 | 302.37 | 300.82 | 333.11
14 | 0 | 264.64 | 323.59 | 322.83 | 388.38
15 | 1 | 381.95 | 340.66 | 311.1 | 373.8
16 | 2 | 272.8 | 299.23 | 295.77 | 351.59
17 | 3 | 257.68 | 315.09 | 298.95 | 355.6
18 | 4 | 261.99 | 314.22 | 302.9 | 351.28
19 | 5 | 266.17 | 302.85 | 305.06 | 335.26
20 | 6 | 263.49 | 297.61 | 299.23 | 327.61
21 | 0 | 260.82 | 328.05 | 325.53 | 390.89
22 | 1 | 307.73 | 326.4 | 302.46 | 363.59
23 | 2 | 273.76 | 300.24 | 296.81 | 355.1
24 | 3 | 262.42 | 316.7 | 302.56 | 355.73
25 | 4 | 263.33 | 309.48 | 298.42 | 347.11
26 | 5 | 265.93 | 301.16 | 301.2 | 335.65
27 | 6 | 260.5 | 295.16 | 293.72 | 327
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
