ban9975/Thesis/5 Result/wristband/calibrated/v4_train_gesture.xlsx

 | gesture | 0 | 1 | 2 | 3
0 | 0 | 2.13 | 20.69 | 24.69 | 39.95
1 | 1 | 85.01 | 53.07 | 3.58 | 26.13
2 | 2 | 14.24 | -10.28 | -13.36 | -5.99
3 | 3 | 4.4 | 15.11 | 0.55 | 1.71
4 | 4 | 7.22 | 2.87 | -13.06 | 1.93
5 | 5 | 8.36 | -4.04 | -8.62 | -21.27
6 | 6 | 6.43 | -13.22 | -6.65 | -19.64
7 | 0 | 10.47 | 35.12 | 32.19 | 49.38
8 | 1 | 66.43 | 44.44 | 0.08 | 15.9
9 | 2 | 19.8 | -0.27 | -11.87 | -3.75
10 | 3 | 8.01 | 15.23 | -0.44 | 2.36
11 | 4 | 7.69 | -0.01 | -10.83 | 1.5
12 | 5 | 8.16 | -7.69 | -10.78 | -17.92
13 | 6 | 5.96 | -11.83 | -7.1 | -15.46
14 | 0 | 9.24 | 29.3 | 25.52 | 40.62
15 | 1 | 59.57 | 39.38 | -5.06 | 12.65
16 | 2 | 19.59 | -0.75 | -13.51 | -5.15
17 | 3 | 7.81 | 18.08 | -5.42 | -2.06
18 | 4 | 8.32 | 2.12 | -9.73 | 5.4
19 | 5 | 8.76 | -10.98 | -17.55 | -24.12
20 | 6 | 6.27 | -14.76 | -13.65 | -23.28
21 | 0 | 7.81 | 24.21 | 19.45 | 35.73
22 | 1 | 44.32 | 26.41 | -8.22 | 7.16
23 | 2 | 13.06 | -6.26 | -15.71 | -7.44
24 | 3 | 5.18 | 6.38 | -9.98 | -10.26
25 | 4 | 2.52 | -3.42 | -16.44 | -4.52
26 | 5 | 3.82 | -10.58 | -17.31 | -24.83
27 | 6 | 2.78 | -12.43 | -15.51 | -21.01
28 | 0 | 6 | 35.62 | 23.05 | 38.95
29 | 1 | 50.09 | 31.91 | -7.61 | 8.7
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
