ban9975/Thesis/5 Result/wristband/calibrated/v4_train_length.xlsx

 | gesture | 0 | 1 | 2 | 3
0 | 0 | 0.0007 | 0.0061 | 0.0072 | 0.0103
1 | 1 | 0.0372 | 0.0164 | 0.001 | 0.0066
2 | 2 | 0.005 | -0.0028 | -0.0037 | -0.0013
3 | 3 | 0.0015 | 0.0044 | 0.0001 | 0.0005
4 | 4 | 0.0025 | 0.0009 | -0.0036 | 0.0006
5 | 5 | 0.0029 | -0.0011 | -0.0024 | -0.0048
6 | 6 | 0.0022 | -0.0036 | -0.0019 | -0.0045
7 | 0 | 0.0037 | 0.0105 | 0.0095 | 0.0129
8 | 1 | 0.0272 | 0.0135 | 0 | 0.004
9 | 2 | 0.0071 | 0 | -0.0033 | -0.0008
10 | 3 | 0.0028 | 0.0044 | -0.0001 | 0.0007
11 | 4 | 0.0027 | 0 | -0.003 | 0.0005
12 | 5 | 0.0028 | -0.0021 | -0.003 | -0.0041
13 | 6 | 0.0021 | -0.0032 | -0.002 | -0.0035
14 | 0 | 0.0032 | 0.0087 | 0.0075 | 0.0105
15 | 1 | 0.0238 | 0.0119 | -0.0014 | 0.0032
16 | 2 | 0.007 | -0.0002 | -0.0037 | -0.0011
17 | 3 | 0.0027 | 0.0053 | -0.0015 | -0.0004
18 | 4 | 0.0029 | 0.0006 | -0.0027 | 0.0014
19 | 5 | 0.0031 | -0.003 | -0.0048 | -0.0055
20 | 6 | 0.0022 | -0.004 | -0.0038 | -0.0053
21 | 0 | 0.0027 | 0.0071 | 0.0056 | 0.0092
22 | 1 | 0.0169 | 0.0078 | -0.0023 | 0.0019
23 | 2 | 0.0046 | -0.0017 | -0.0043 | -0.0016
24 | 3 | 0.0018 | 0.0019 | -0.0028 | -0.0023
25 | 4 | 0.0009 | -0.0009 | -0.0045 | -0.001
26 | 5 | 0.0013 | -0.0029 | -0.0048 | -0.0057
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
