ban9975/Thesis/5 Result/wristband/calibrated/v4_train_raw.xlsx

 | gesture | 0 | 1 | 2 | 3
0 | 0 | 257.14 | 340.55 | 343.3 | 427.4
1 | 1 | 340.02 | 372.93 | 322.19 | 413.58
2 | 2 | 269.25 | 309.58 | 305.25 | 381.46
3 | 3 | 259.41 | 334.97 | 319.16 | 389.16
4 | 4 | 262.23 | 322.73 | 305.55 | 389.38
5 | 5 | 263.37 | 315.82 | 309.99 | 366.18
6 | 6 | 261.44 | 306.64 | 311.96 | 367.81
7 | 0 | 265.48 | 354.98 | 350.8 | 436.83
8 | 1 | 321.44 | 364.3 | 318.69 | 403.35
9 | 2 | 274.81 | 319.59 | 306.74 | 383.7
10 | 3 | 263.02 | 335.09 | 318.17 | 389.81
11 | 4 | 262.7 | 319.85 | 307.78 | 388.95
12 | 5 | 263.17 | 312.17 | 307.83 | 369.53
13 | 6 | 260.97 | 308.03 | 311.51 | 371.99
14 | 0 | 264.25 | 349.16 | 344.13 | 428.07
15 | 1 | 314.58 | 359.24 | 313.55 | 400.1
16 | 2 | 274.6 | 319.11 | 305.1 | 382.3
17 | 3 | 262.82 | 337.94 | 313.19 | 385.39
18 | 4 | 263.33 | 321.98 | 308.88 | 392.85
19 | 5 | 263.77 | 308.88 | 301.06 | 363.33
20 | 6 | 261.28 | 305.1 | 304.96 | 364.17
21 | 0 | 262.82 | 344.07 | 338.06 | 423.18
22 | 1 | 299.33 | 346.27 | 310.39 | 394.61
23 | 2 | 268.07 | 313.6 | 302.9 | 380.01
24 | 3 | 260.19 | 326.24 | 308.63 | 377.19
25 | 4 | 257.53 | 316.44 | 302.17 | 382.93
26 | 5 | 258.83 | 309.28 | 301.3 | 362.62
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
