ban9975/Thesis/3 Data/wristbands/v1_test.xlsx

gesture | start | end | 0 | 1 | 2 | 3
0 | 0:01:27.481966 | 0:01:29.526585 | 2339.62 | 2503.49 | 520.35 | 420.56
0 | 0:02:15.272663 | 0:02:15.623366 | 2144.17 | 2248.52 | 512.59 | 417.33
0 | 0:02:39.252115 | 0:02:39.919387 | 1803.31 | 1850.08 | 502.3 | 398.38
0 | 0:03:02.467907 | 0:03:02.736774 | 1801.14 | 1999.96 | 488.37 | 409.89
0 | 0:03:29.514929 | 0:03:29.783444 | 1604.74 | 1675.57 | 478.37 | 373.53
1 | 0:01:37.528722 | 0:01:37.868640 | 2311.38 | 2307.9 | 450.12 | 536.82
1 | 0:02:18.567913 | 0:02:18.866649 | 1999.96 | 2093.94 | 450.02 | 537.8
1 | 0:02:42.414347 | 0:02:43.166548 | 1809.85 | 1787.15 | 415.41 | 492.66
1 | 0:03:05.625729 | 0:03:05.976930 | 1654.08 | 1689.87 | 417.25 | 453.22
1 | 0:03:32.279332 | 0:03:33.025628 | 1549.89 | 1622.36 | 413.9 | 444.37
2 | 0:01:45.089253 | 0:01:45.375877 | 2181.02 | 1774.41 | 478.47 | 402.97
2 | 0:02:23.266052 | 0:02:23.533717 | 1730.16 | 1443.69 | 413.98 | 390.75
2 | 0:02:45.678185 | 0:02:46.416808 | 1684.12 | 1402.63 | 413.43 | 396.23
2 | 0:03:12.414276 | 0:03:12.688504 | 1652.23 | 1369.51 | 406.33 | 361.47
2 | 0:03:35.129183 | 0:03:36.282735 | 1501.54 | 1335.34 | 403.8 | 360.32
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
