ban9975/Thesis/3 Data/wristbands/v2_test.xlsx

gesture | start | end | 0 | 1 | 2 | 3
0 | 0:00:57.831551 | 0:00:58.190489 | 1442.26 | 1471.34 | 460.48 | 418.94
0 | 0:01:02.178167 | 0:01:02.450114 | 1260.91 | 1338.43 | 449.03 | 410.99
0 | 0:01:05.738022 | 0:01:06.006173 | 1092.04 | 1188.83 | 423.92 | 399.58
0 | 0:01:09.493200 | 0:01:09.763799 | 1072.75 | 1105.84 | 411.46 | 384.54
0 | 0:01:12.069423 | 0:01:13.012229 | 1145.02 | 1145.95 | 411.06 | 389.09
1 | 0:01:18.089147 | 0:01:18.368703 | 1437.28 | 1416.3 | 426.57 | 573.9
1 | 0:01:20.691425 | 0:01:21.607252 | 1464.7 | 1428.12 | 407.1 | 560.68
1 | 0:01:23.324462 | 0:01:24.859318 | 1624.14 | 1471.34 | 399.2 | 533.79
1 | 0:01:26.992608 | 0:01:28.100291 | 1521.8 | 1476.54 | 398.38 | 521.85
1 | 0:01:30.406022 | 0:01:31.347192 | 1440.12 | 1404.66 | 385.11 | 505.8
2 | 0:01:35.923989 | 0:01:36.196489 | 1459.58 | 1463.23 | 403.8 | 426.32
2 | 0:01:39.594383 | 0:01:39.861826 | 1490.08 | 1457.39 | 406.25 | 433.56
2 | 0:01:41.502758 | 0:01:43.106372 | 1468.38 | 1458.85 | 406.1 | 435.53
2 | 0:01:44.665269 | 0:01:46.349993 | 1447.27 | 1440.83 | 404.26 | 426.98
2 | 0:01:48.436517 | 0:01:49.596591 | 1437.28 | 1428.12 | 407.18 | 435.02
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
