ban9975/Thesis/3 Data/wristbands/v3_test.xlsx

Sheet: calibration_
gesture | start | end | 0 | 1 | 2 | 3
6 | 0:00:13.334889 | 0:00:13.611933 | 335.88 | 336.8 | 366.31 | 343.66
6 | 0:00:35.000814 | 0:00:35.271961 | 315.25 | 329.31 | 323.69 | 346.39
6 | 0:00:36.895525 | 0:00:38.521999 | 322.89 | 332.6 | 320.27 | 350.55
6 | 0:00:39.836524 | 0:00:41.762216 | 317.54 | 328.05 | 318.48 | 346.27
6 | 0:00:42.847403 | 0:00:45.013331 | 316.55 | 327.06 | 316.81 | 343.01
6 | 0:01:39.762424 | 0:01:40.021312 | 338.23 | 312.83 | 318.64 | 317.9
6 | 0:01:44.345813 | 0:01:44.616305 | 338.46 | 313.65 | 320.27 | 319.27
6 | 0:01:46.363791 | 0:01:47.858116 | 337.83 | 313.6 | 319.8 | 318.53
6 | 0:01:48.956176 | 0:01:51.096793 | 337.2 | 313.29 | 318.38 | 317.69
6 | 0:01:51.700499 | 0:01:54.353821 | 336.97 | 314.16 | 317.85 | 321.5
6 | 0:01:55.422237 | 0:01:57.595078 | 336.85 | 312.12 | 316.96 | 320.91
6 | 0:01:58.491068 | 0:02:00.840193 | 336.45 | 312.83 | 317.96 | 319.96
6 | 0:02:02.407491 | 0:02:04.097561 | 335.77 | 312.68 | 317.54 | 319.27
6 | 0:02:05.024500 | 0:02:07.333124 | 336.97 | 313.75 | 317.07 | 321.82
6 | 0:02:08.275593 | 0:02:10.567464 | 337.66 | 311.96 | 316.39 | 321.55
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
