ban9975/Thesis/5 Result/wristband/calibrated/v1_test_raw.xlsx

 | gesture | 0 | 1 | 2 | 3
0 | 0 | 2339.62 | 2503.49 | 520.35 | 420.56
1 | 0 | 2144.17 | 2248.52 | 512.59 | 417.33
2 | 0 | 1803.31 | 1850.08 | 502.3 | 398.38
3 | 0 | 1801.14 | 1999.96 | 488.37 | 409.89
4 | 0 | 1604.74 | 1675.57 | 478.37 | 373.53
5 | 1 | 2311.38 | 2307.9 | 450.12 | 536.82
6 | 1 | 1999.96 | 2093.94 | 450.02 | 537.8
7 | 1 | 1809.85 | 1787.15 | 415.41 | 492.66
8 | 1 | 1654.08 | 1689.87 | 417.25 | 453.22
9 | 1 | 1549.89 | 1622.36 | 413.9 | 444.37
10 | 2 | 2181.02 | 1774.41 | 478.47 | 402.97
11 | 2 | 1730.16 | 1443.69 | 413.98 | 390.75
12 | 2 | 1684.12 | 1402.63 | 413.43 | 396.23
13 | 2 | 1652.23 | 1369.51 | 406.33 | 361.47
14 | 2 | 1501.54 | 1335.34 | 403.8 | 360.32
15 | 3 | 2179.46 | 2250.18 | 524.06 | 414.77
16 | 3 | 1763.93 | 1809.85 | 474.48 | 404.26
17 | 3 | 1664.29 | 1643.07 | 458.5 | 377.46
18 | 3 | 1792.51 | 1881.38 | 494.46 | 377.46
19 | 3 | 1689.87 | 1450.87 | 461.42 | 372.72
20 | 4 | 2136.64 | 2188.85 | 448.31 | 421.29
21 | 4 | 1738.24 | 1812.05 | 438.39 | 400.63
22 | 4 | 1668.03 | 1748.43 | 423.92 | 373.13
23 | 4 | 1711.27 | 1486.29 | 428.82 | 362.17
24 | 4 | 1599.52 | 1263.7 | 410.05 | 361.08
25 | 5 | 1990.74 | 2111.41 | 405.56 | 401.08
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
