ban9975/Thesis/5 Result/wristband/calibrated/v1_train_raw.xlsx

 | gesture | 0 | 1 | 2 | 3
0 | 0 | 1975.12 | 2123.21 | 392.56 | 520.46
1 | 0 | 1850.08 | 2010.6 | 372.05 | 487.85
2 | 0 | 1873.16 | 1948.34 | 362.11 | 464.65
3 | 0 | 1800.06 | 1954.65 | 357.1 | 459.72
4 | 0 | 1753.57 | 1877.85 | 362.11 | 451.12
5 | 0 | 1820.86 | 1959.73 | 355.85 | 451.02
6 | 0 | 1760.81 | 1905.21 | 348.13 | 424
7 | 0 | 1789.29 | 1918.57 | 388.66 | 456.64
8 | 0 | 1773.36 | 1896.81 | 372.46 | 473.89
9 | 0 | 1813.14 | 1881.38 | 374 | 465.8
10 | 0 | 1567.22 | 1884.91 | 374.34 | 468.31
11 | 0 | 1603.87 | 1938.32 | 386.03 | 478.27
12 | 0 | 1427.42 | 1934.59 | 361.08 | 459.35
13 | 0 | 1414.23 | 1902.8 | 372.66 | 449.03
14 | 0 | 1377.98 | 1861.55 | 364.04 | 443.92
15 | 1 | 1792.51 | 1942.07 | 482.51 | 396.67
16 | 1 | 1768.11 | 1916.13 | 483.33 | 398.75
17 | 1 | 1785.01 | 1648.56 | 494.25 | 389.38
18 | 1 | 1747.4 | 1593.48 | 496.37 | 380.15
19 | 1 | 1746.38 | 1940.82 | 497.12 | 382.79
20 | 1 | 1771.26 | 1562.23 | 492.03 | 402.97
21 | 1 | 1756.67 | 1584.92 | 491.72 | 385.81
22 | 1 | 1795.73 | 1703.43 | 488.69 | 378.29
23 | 1 | 1750.48 | 1596.93 | 488.37 | 383.14
24 | 1 | 1788.22 | 2013.27 | 469.09 | 373.93
25 | 1 | 1708.32 | 1536.13 | 477.57 | 375.42
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
