ban9975/Thesis/5 Result/wristband/calibrated/v2_test_raw.xlsx

 | gesture | 0 | 1 | 2 | 3
0 | 0 | 1442.26 | 1471.34 | 460.48 | 418.94
1 | 0 | 1260.91 | 1338.43 | 449.03 | 410.99
2 | 0 | 1092.04 | 1188.83 | 423.92 | 399.58
3 | 0 | 1072.75 | 1105.84 | 411.46 | 384.54
4 | 0 | 1145.02 | 1145.95 | 411.06 | 389.09
5 | 1 | 1437.28 | 1416.3 | 426.57 | 573.9
6 | 1 | 1464.7 | 1428.12 | 407.1 | 560.68
7 | 1 | 1624.14 | 1471.34 | 399.2 | 533.79
8 | 1 | 1521.8 | 1476.54 | 398.38 | 521.85
9 | 1 | 1440.12 | 1404.66 | 385.11 | 505.8
10 | 2 | 1459.58 | 1463.23 | 403.8 | 426.32
11 | 2 | 1490.08 | 1457.39 | 406.25 | 433.56
12 | 2 | 1468.38 | 1458.85 | 406.1 | 435.53
13 | 2 | 1447.27 | 1440.83 | 404.26 | 426.98
14 | 2 | 1437.28 | 1428.12 | 407.18 | 435.02
15 | 3 | 1481.78 | 1399.25 | 500.78 | 451.02
16 | 3 | 1524.17 | 1423.23 | 495.52 | 442.77
17 | 3 | 1507.72 | 1395.89 | 494.78 | 428.82
18 | 3 | 1489.32 | 1387.87 | 490.77 | 431.77
19 | 3 | 1490.08 | 1381.92 | 481.19 | 424
20 | 4 | 1529.73 | 1458.85 | 457.1 | 429.91
21 | 4 | 1484.03 | 1417.68 | 454.14 | 404.34
22 | 4 | 1475.8 | 1423.23 | 446.42 | 393.36
23 | 4 | 1480.28 | 1430.92 | 456.45 | 400.78
24 | 4 | 1517.86 | 1434.45 | 448.67 | 394.76
25 | 5 | 1461.77 | 1403.99 | 400.7 | 473.89
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
