ban9975/Thesis/5 Result/wristband/calibrated/v2_train_raw.xlsx

 | gesture | 0 | 1 | 2 | 3
0 | 0 | 1405.34 | 1475.05 | 451.12 | 448.76
1 | 0 | 1387.21 | 1399.25 | 440.39 | 433.65
2 | 0 | 1388.54 | 1427.42 | 426.15 | 426.98
3 | 0 | 1385.22 | 1463.23 | 430.59 | 433.99
4 | 0 | 1426.72 | 1442.97 | 432.11 | 426.98
5 | 0 | 1430.92 | 1486.29 | 448.13 | 434.25
6 | 0 | 1419.76 | 1461.04 | 448.04 | 435.62
7 | 0 | 1469.12 | 1507.72 | 437.95 | 439.08
8 | 0 | 1412.86 | 1464.7 | 440.57 | 438.21
9 | 0 | 1433.74 | 1475.8 | 438.3 | 432.96
10 | 0 | 1393.88 | 1460.31 | 425.9 | 423.34
11 | 0 | 1416.99 | 1462.5 | 441.8 | 435.45
12 | 0 | 1419.06 | 1412.17 | 438.13 | 428.74
13 | 0 | 1434.45 | 1469.86 | 443.04 | 439.61
14 | 0 | 1410.8 | 1418.37 | 437.69 | 430.5
15 | 0 | 1407.39 | 1461.04 | 428.4 | 424.16
16 | 0 | 1418.37 | 1493.12 | 440.04 | 441.54
17 | 0 | 1426.72 | 1488.56 | 433.56 | 434.93
18 | 0 | 1438.7 | 1494.64 | 443.12 | 449.93
19 | 0 | 1442.97 | 1520.22 | 443.83 | 438.65
20 | 0 | 1435.86 | 1520.22 | 446.6 | 437.78
21 | 0 | 1423.93 | 1484.79 | 438.65 | 435.53
22 | 0 | 1419.06 | 1481.03 | 437.09 | 429.24
23 | 0 | 1425.32 | 1453.04 | 436.48 | 427.65
24 | 0 | 1428.82 | 1461.77 | 434.5 | 425.98
25 | 0 | 1413.55 | 1465.44 | 442.68 | 427.82
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
