ban9975/Thesis/5 Result/wristband/calibrated/v3_test_gesture.xlsx

 | gesture | 0 | 1 | 2 | 3
0 | 0 | -0.33 | 25.56 | 10.11 | 34.97
1 | 1 | 26.83 | 35.19 | 15.55 | 59.97
2 | 2 | -3.32 | 29.45 | -4.9 | 43.71
3 | 3 | -16.94 | 18.1 | -9.54 | 26.55
4 | 4 | -9.52 | 17.13 | 8.61 | 26.43
5 | 5 | -22.5 | 9.29 | -22.91 | 18.02
6 | 6 | 17.61 | 13.34 | 10.28 | 11.77
7 | 0 | -3.93 | 2.68 | -1.06 | 14.05
8 | 1 | 11.45 | 34.64 | 47.31 | 34.91
9 | 2 | 7.99 | 33.84 | 58.59 | 37.89
10 | 3 | -4.31 | 34.82 | 12.93 | 30.38
11 | 4 | -10.64 | 18.73 | 30.01 | 19.04
12 | 5 | -21.74 | 14.01 | 14.81 | 21.21
13 | 6 | 4.14 | 31.09 | -13.78 | 11.18
14 | 0 | 6.78 | 27.59 | 8.55 | 29.12
15 | 1 | -9.14 | 12.44 | -14.03 | 11.18
16 | 2 | -1.27 | 22.56 | 20.72 | 28.11
17 | 3 | -9.25 | 25.92 | 7.44 | 15.34
18 | 4 | -9.57 | 14.46 | 42.41 | 14.57
19 | 5 | -77.77 | 26.69 | -26.13 | 8.25
20 | 6 | -18.89 | 16.05 | -8.01 | -1.22
21 | 0 | -40.12 | -31.49 | -49.79 | -13.66
22 | 1 | -32.17 | -35.98 | -46.57 | -22.06
23 | 2 | -45.21 | -41.15 | -57.32 | -22.16
24 | 3 | -47.53 | -46.8 | -57.08 | -27.39
25 | 4 | -50.18 | -47.72 | -51.57 | -25.11
26 | 5 | -53.3 | -51.64 | -60.2 | -32.31
27 | 6 | -55.69 | -50.55 | -53.12 | -32.54
28 | 0 | -52.18 | -24.1 | -58.15 | -23.4
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
