ban9975/Thesis/5 Result/wristband/calibrated/v3_test_length.xlsx

 | gesture | 0 | 1 | 2 | 3
0 | 0 | -0.0001 | 0.0076 | 0.0029 | 0.01
1 | 1 | 0.0076 | 0.0106 | 0.0044 | 0.0181
2 | 2 | -0.0009 | 0.0088 | -0.0014 | 0.0128
3 | 3 | -0.0045 | 0.0053 | -0.0026 | 0.0075
4 | 4 | -0.0026 | 0.005 | 0.0024 | 0.0074
5 | 5 | -0.0059 | 0.0027 | -0.0062 | 0.0049
6 | 6 | 0.0049 | 0.0039 | 0.0029 | 0.0032
7 | 0 | -0.0011 | 0.0008 | -0.0003 | 0.0038
8 | 1 | 0.0032 | 0.0104 | 0.0143 | 0.01
9 | 2 | 0.0022 | 0.0102 | 0.0182 | 0.0109
10 | 3 | -0.0012 | 0.0105 | 0.0037 | 0.0086
11 | 4 | -0.0029 | 0.0055 | 0.0088 | 0.0052
12 | 5 | -0.0057 | 0.0041 | 0.0042 | 0.0059
13 | 6 | 0.0011 | 0.0093 | -0.0038 | 0.003
14 | 0 | 0.0018 | 0.0082 | 0.0024 | 0.0082
15 | 1 | -0.0025 | 0.0037 | -0.0038 | 0.003
16 | 2 | -0.0004 | 0.0067 | 0.006 | 0.0079
17 | 3 | -0.0025 | 0.0077 | 0.0021 | 0.0042
18 | 4 | -0.0026 | 0.0043 | 0.0127 | 0.004
19 | 5 | -0.019 | 0.0079 | -0.007 | 0.0022
20 | 6 | -0.005 | 0.0047 | -0.0022 | -0.0005
21 | 0 | -0.0103 | -0.0084 | -0.0129 | -0.0038
22 | 1 | -0.0083 | -0.0095 | -0.0121 | -0.0059
23 | 2 | -0.0115 | -0.0108 | -0.0147 | -0.006
24 | 3 | -0.0121 | -0.0122 | -0.0146 | -0.0073
25 | 4 | -0.0127 | -0.0124 | -0.0133 | -0.0067
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
