ban9975/Thesis/5 Result/wristband/calibrated/v3_test_raw.xlsx

 | gesture | 0 | 1 | 2 | 3
0 | 0 | 331.7 | 344.54 | 331.87 | 363.52
1 | 1 | 358.86 | 354.17 | 337.31 | 388.52
2 | 2 | 328.71 | 348.43 | 316.86 | 372.26
3 | 3 | 315.09 | 337.08 | 312.22 | 355.1
4 | 4 | 322.51 | 336.11 | 330.37 | 354.98
5 | 5 | 309.53 | 328.27 | 298.85 | 346.57
6 | 6 | 349.64 | 332.32 | 332.04 | 340.32
7 | 0 | 328.1 | 321.66 | 320.7 | 342.6
8 | 1 | 343.48 | 353.62 | 369.07 | 363.46
9 | 2 | 340.02 | 352.82 | 380.35 | 366.44
10 | 3 | 327.72 | 353.8 | 334.69 | 358.93
11 | 4 | 321.39 | 337.71 | 351.77 | 347.59
12 | 5 | 310.29 | 332.99 | 336.57 | 349.76
13 | 6 | 336.17 | 350.07 | 307.98 | 339.73
14 | 0 | 338.81 | 346.57 | 330.31 | 357.67
15 | 1 | 322.89 | 331.42 | 307.73 | 339.73
16 | 2 | 330.76 | 341.54 | 342.48 | 356.66
17 | 3 | 322.78 | 344.9 | 329.2 | 343.89
18 | 4 | 322.46 | 333.44 | 364.17 | 343.12
19 | 5 | 254.26 | 345.67 | 295.63 | 336.8
20 | 6 | 313.14 | 335.03 | 313.75 | 327.33
21 | 0 | 291.91 | 287.49 | 271.97 | 314.89
22 | 1 | 299.86 | 283 | 275.19 | 306.49
23 | 2 | 286.82 | 277.83 | 264.44 | 306.39
24 | 3 | 284.5 | 272.18 | 264.68 | 301.16
25 | 4 | 281.85 | 271.26 | 270.19 | 303.44
26 | 5 | 278.73 | 267.34 | 261.56 | 296.24
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
