ban9975/Thesis/5 Result/wristband/calibrated/v3_train_gesture.xlsx

 | gesture | 0 | 1 | 2 | 3
0 | 0 | 16.28 | 27.01 | 19.52 | 7.2
1 | 1 | 37.06 | 47.71 | 20.15 | 29.8
2 | 2 | 16.73 | 13.69 | 6.89 | 15.05
3 | 3 | 11.45 | 13.98 | 41.36 | 7.39
4 | 4 | 11.84 | -9.5 | 15.58 | -5.2
5 | 5 | 8.36 | 3.89 | 9.48 | 10.17
6 | 6 | 8.47 | -3.91 | 13.25 | 5.76
7 | 0 | 20.18 | 30.74 | 16.36 | 5.45
8 | 1 | 37.49 | 51.78 | 8.99 | 18.92
9 | 2 | 10.95 | 26.89 | 3.49 | 17.34
10 | 3 | 13.23 | 22.76 | 7.86 | 11.12
11 | 4 | 6.07 | 5.48 | 10.24 | -2.57
12 | 5 | 0.4 | 12.44 | -2.48 | 4.95
13 | 6 | 1.94 | 9.13 | 11.27 | 2.23
14 | 0 | 29.63 | 52.93 | 26.15 | 18.79
15 | 1 | 20.7 | 35.46 | 5.56 | 10.36
16 | 2 | 9.46 | 24.67 | 5.98 | 11.57
17 | 3 | 41.4 | 18.99 | 7.8 | 4.14
18 | 4 | -1.07 | 9.74 | 16.08 | 6.7
19 | 5 | -2.27 | -1.22 | -11.4 | -1.18
20 | 6 | -5.53 | -4.17 | 42.99 | 0.09
21 | 0 | 28.13 | 37.41 | 31.25 | 8.9
22 | 1 | 19.48 | 37.73 | 11.17 | 14.15
23 | 2 | 5.47 | 14.49 | 3.7 | -0.28
24 | 3 | 9.46 | 26.71 | 30.17 | -2.33
25 | 4 | 32.55 | 19.7 | 42.55 | 0.88
26 | 5 | -6.75 | 9.29 | -0.06 | 0.64
27 | 6 | -7.77 | 6.03 | -2.64 | -6.09
28 | 0 | 22.27 | 45.47 | 31.31 | 11.7
29 | 1 | 33.22 | 40.02 | 4.92 | 10.17
30 | 2 | 0.35 | 7.79 | -2.33 | -2.57
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
