ban9975/Thesis/5 Result/wristband/calibrated/v3_train_length.xlsx

 | gesture | 0 | 1 | 2 | 3
0 | 0 | 0.0048 | 0.008 | 0.0057 | 0.0018
1 | 1 | 0.0112 | 0.0146 | 0.0059 | 0.008
2 | 2 | 0.0049 | 0.004 | 0.002 | 0.0039
3 | 3 | 0.0034 | 0.0041 | 0.0126 | 0.0018
4 | 4 | 0.0035 | -0.0025 | 0.0045 | -0.0014
5 | 5 | 0.0025 | 0.0012 | 0.0027 | 0.0026
6 | 6 | 0.0025 | -0.001 | 0.0039 | 0.0014
7 | 0 | 0.0059 | 0.0091 | 0.0048 | 0.0013
8 | 1 | 0.0113 | 0.0159 | 0.0026 | 0.0049
9 | 2 | 0.0032 | 0.0079 | 0.001 | 0.0045
10 | 3 | 0.0039 | 0.0067 | 0.0023 | 0.0028
11 | 4 | 0.0018 | 0.0016 | 0.003 | -0.0008
12 | 5 | 0.0002 | 0.0036 | -0.0007 | 0.0012
13 | 6 | 0.0006 | 0.0027 | 0.0033 | 0.0005
14 | 0 | 0.0088 | 0.0163 | 0.0078 | 0.0049
15 | 1 | 0.0061 | 0.0106 | 0.0016 | 0.0026
16 | 2 | 0.0028 | 0.0072 | 0.0017 | 0.0029
17 | 3 | 0.0126 | 0.0055 | 0.0022 | 0.001
18 | 4 | -0.0002 | 0.0028 | 0.0047 | 0.0017
19 | 5 | -0.0006 | -0.0003 | -0.0032 | -0.0004
20 | 6 | -0.0015 | -0.0011 | 0.0132 | -0.0001
21 | 0 | 0.0084 | 0.0112 | 0.0094 | 0.0022
22 | 1 | 0.0057 | 0.0113 | 0.0032 | 0.0036
23 | 2 | 0.0016 | 0.0042 | 0.0011 | -0.0002
24 | 3 | 0.0028 | 0.0079 | 0.009 | -0.0007
25 | 4 | 0.0098 | 0.0058 | 0.013 | 0.0001
26 | 5 | -0.0018 | 0.0027 | 0 | 0.0001
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
