ban9975/Thesis/5 Result/wristband/calibrated/v3_train_raw.xlsx

 | gesture | 0 | 1 | 2 | 3
0 | 0 | 335.2 | 349.03 | 335.14 | 357.48
1 | 1 | 355.98 | 369.73 | 335.77 | 380.08
2 | 2 | 335.65 | 335.71 | 322.51 | 365.33
3 | 3 | 330.37 | 336 | 356.98 | 357.67
4 | 4 | 330.76 | 312.52 | 331.2 | 345.08
5 | 5 | 327.28 | 325.91 | 325.1 | 360.45
6 | 6 | 327.39 | 318.11 | 328.87 | 356.04
7 | 0 | 339.1 | 352.76 | 331.98 | 355.73
8 | 1 | 356.41 | 373.8 | 324.61 | 369.2
9 | 2 | 329.87 | 348.91 | 319.11 | 367.62
10 | 3 | 332.15 | 344.78 | 323.48 | 361.4
11 | 4 | 324.99 | 327.5 | 325.86 | 347.71
12 | 5 | 319.32 | 334.46 | 313.14 | 355.23
13 | 6 | 320.86 | 331.15 | 326.89 | 352.51
14 | 0 | 348.55 | 374.95 | 341.77 | 369.07
15 | 1 | 339.62 | 357.48 | 321.18 | 360.64
16 | 2 | 328.38 | 346.69 | 321.6 | 361.85
17 | 3 | 360.32 | 341.01 | 323.42 | 354.42
18 | 4 | 317.85 | 331.76 | 331.7 | 356.98
19 | 5 | 316.65 | 320.8 | 304.22 | 349.1
20 | 6 | 313.39 | 317.85 | 358.61 | 350.37
21 | 0 | 347.05 | 359.43 | 346.87 | 359.18
22 | 1 | 338.4 | 359.75 | 326.79 | 364.43
23 | 2 | 324.39 | 336.51 | 319.32 | 350
24 | 3 | 328.38 | 348.73 | 345.79 | 347.95
25 | 4 | 351.47 | 341.72 | 358.17 | 351.16
26 | 5 | 312.17 | 331.31 | 315.56 | 350.92
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
