ban9975/Thesis/5 Result/rubberCord/8cm.png

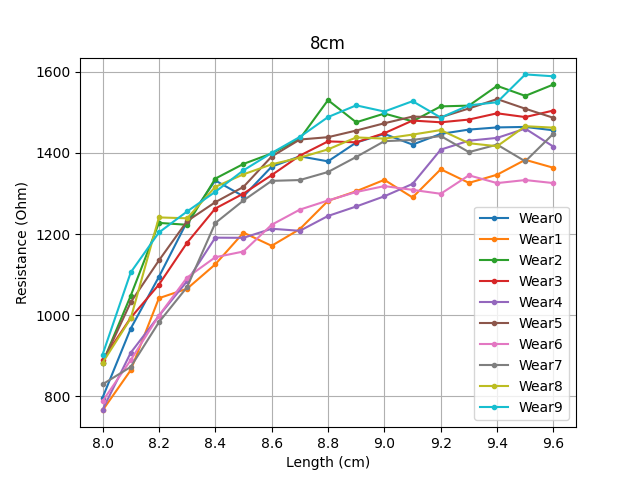
5 Result/rubberCord/8cm.png
