ban9975/Thesis/5 Result/rubberCord/8cm_SD.png

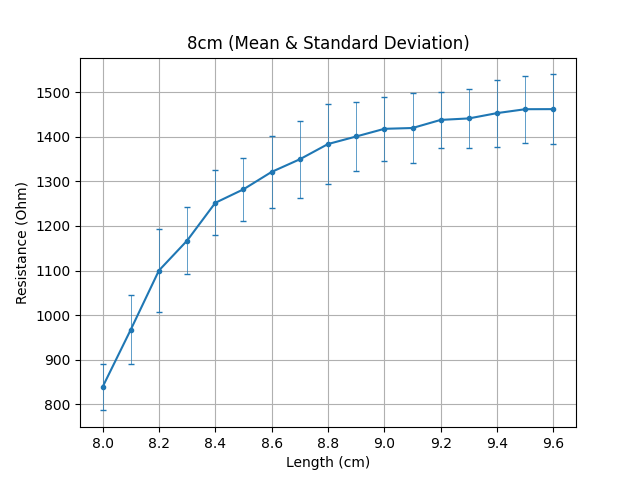
5 Result/rubberCord/8cm_SD.png
