ban9975/Thesis/5 Result/rubberCord/newCord_20_all.png

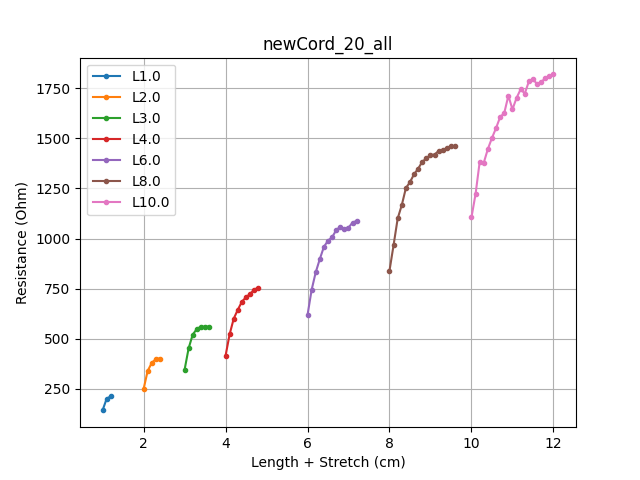
5 Result/rubberCord/newCord_20_all.png
