ban9975/Thesis/5 Result/rubberCord/Overall Rubber Cord Length+Stretch.png

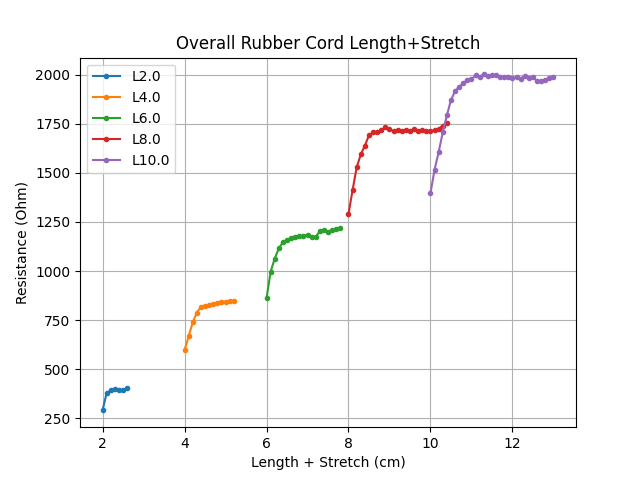
5 Result/rubberCord/Overall Rubber Cord Length+Stretch.png
