ban9975/Thesis/5 Result/rubberCord/Overall Rubber Cord Stretch_20.png

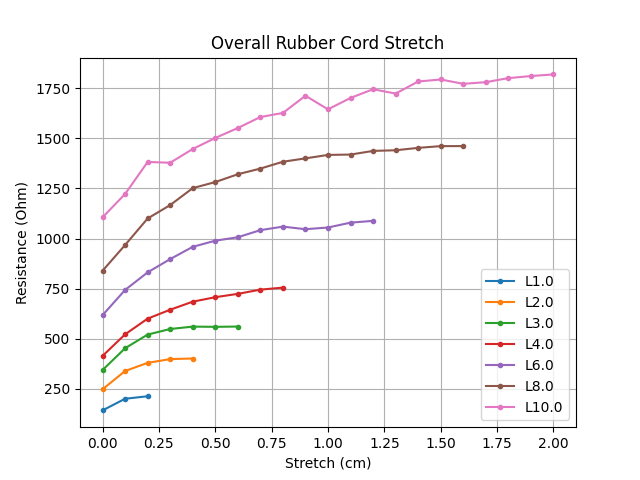
5 Result/rubberCord/Overall Rubber Cord Stretch_20.png
