ban9975/Thesis/5 Result/rubberCord/Overall Rubber Cord Stretch_30.png

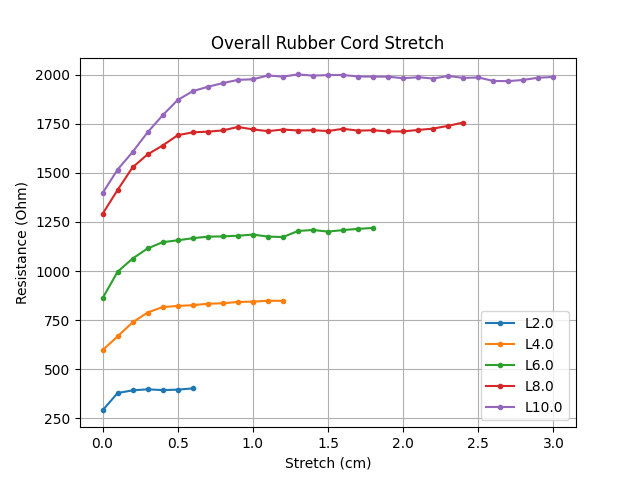
5 Result/rubberCord/Overall Rubber Cord Stretch_30.png
