ban9975/Thesis/5 Result/rubberCord/Rubber Cord 2cm.png

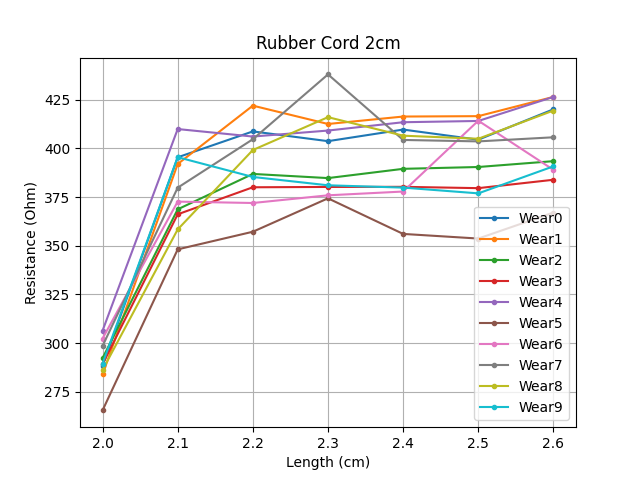
5 Result/rubberCord/Rubber Cord 2cm.png
