ban9975/Thesis/5 Result/rubberCord/Rubber Cord 8cm.png

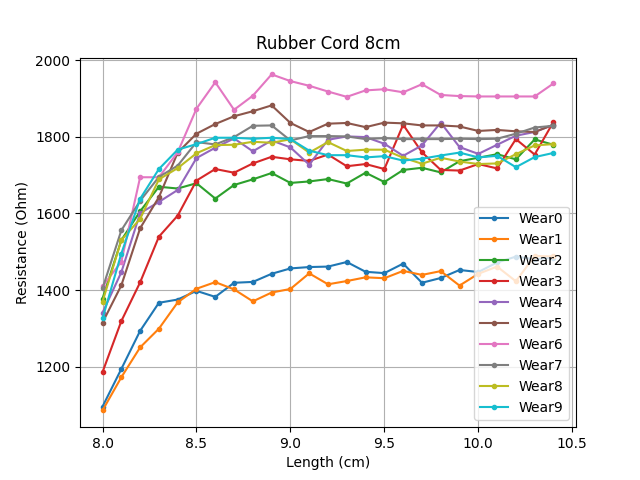
5 Result/rubberCord/Rubber Cord 8cm.png
