ban9975/Thesis/5 Result/wristband/calibrated/plot/v3_raw_2.png

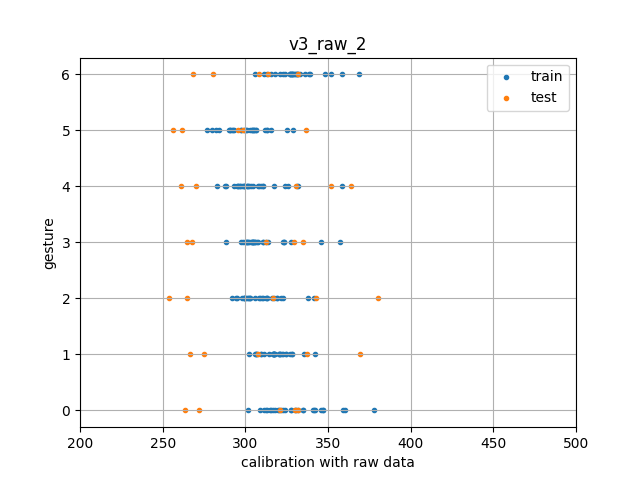
5 Result/wristband/calibrated/plot/v3_raw_2.png
