ban9975/Thesis/5 Result/wristband/calibrated/plot/v4_length_2.png

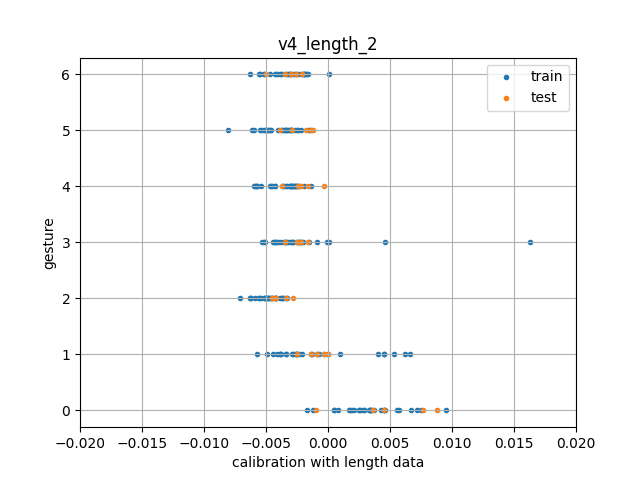
5 Result/wristband/calibrated/plot/v4_length_2.png
