ban9975/Thesis/5 Result/wristband/calibrated/plot/v4_raw_0.png

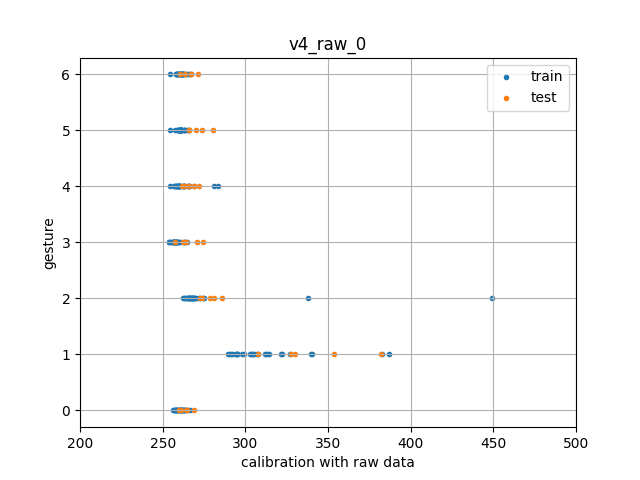
5 Result/wristband/calibrated/plot/v4_raw_0.png
