ban9975/Thesis/5 Result/wristband/calibrated/plot/v4_raw_3.png

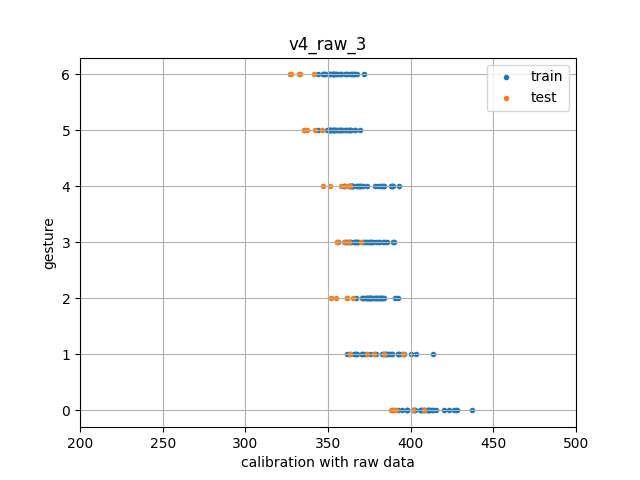
5 Result/wristband/calibrated/plot/v4_raw_3.png
