ban9975/Thesis/5 Result/wristband/conMat/v4_gesture_test.png

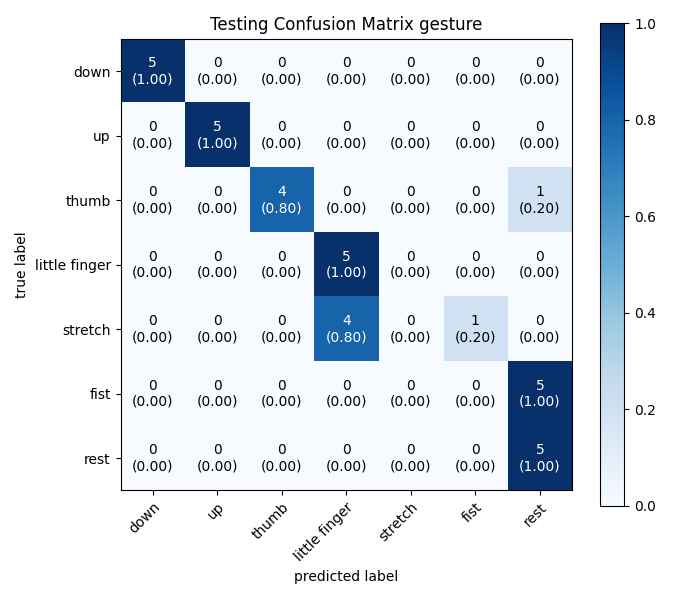
5 Result/wristband/conMat/v4_gesture_test.png
