ban9975/Thesis/5 Result/wristband/conMat/v4_gesture_val.png

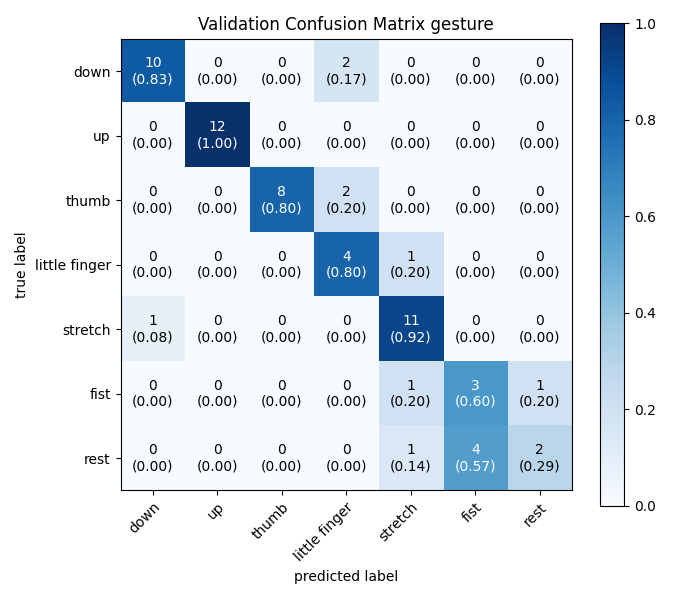
5 Result/wristband/conMat/v4_gesture_val.png
