ban9975/Thesis/4 Program/BT_pyServer/BT.py

from time import sleep
import serial

class bluetooth:
    def __init__(self):
        self.ser = serial.Serial()

    def do_connect(self,port):
        self.ser.close()
        print("Connecting...")
        try:
            self.ser = serial.Serial(port,38400,timeout=2)
            print("connect success")
            print("")
        except serial.serialutil.SerialException as ex:
            print("fail to connect")
            print(ex)
            print("")
            return False
        return True


    def disconnect(self):
        self.ser.close()

    def SerialWrite(self,output):
        # send = 's'.encode("utf-8")
        if output.isdigit():
            send = int(output).to_bytes(1, 'little')
        else:
            send = output.encode("utf-8")
        self.ser.write(send)

    def SerialReadInt(self):
        waiting = self.ser.in_waiting
        if waiting >= 0:
            rv = self.ser.read(2)
            rv=int.from_bytes(rv, byteorder='big', signed=False)
            return rv
        return

    def SerialReadByte(self):
        sleep(0.005)
        waiting = self.ser.inWaiting()
        rv = self.ser.read(waiting)
        return rv
