ban9975/Thesis/(commit log)

2023-07-30 fix filename
    [newCord_20.xlsx]
2023-08-03 fix 4Res
    [v4_test.xlsx]
